ecbarnes116/TAMU_ECEN_403-404_Shared/README.md

# TAMU_ECEN_403-404_Shared
Shared repository for Team 34 - Sandia National Laboratories
