ecbarnes116/TAMU_ECEN_403-404_Shared/403Reports_Presentations/ECEN_403_PHEEDAQ_Final_Update_Presentation.pdf

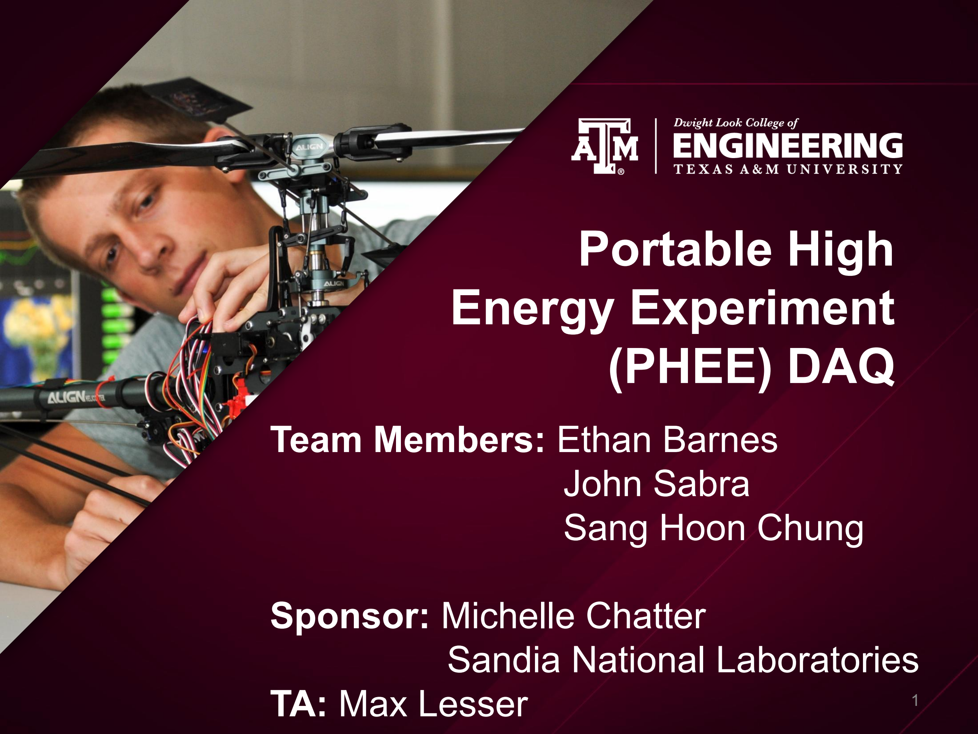
[picture p9: page 1]

# Portable High Energy Experiment (PHEE) DAQ

## Team Members: Ethan Barnes John Sabra Sang Hoon Chung

## Sponsor: Michelle Chatter Sandia National Laboratories

TA: Max Lesser | 1

# Executive Summary

## Problem statement:

- The United States military possesses about 5500 nuclear weapons in its stockpile

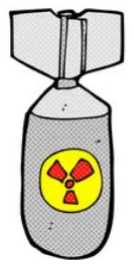
[picture p10: figure]

- The security of these weapons and equipment is paramount when they are transported for storage and testing
- Sandia is interested in detecting explosive-type events in sensitive areas
– Exact application for DAQ system may not be disclosed

## The Portable High Energy DAQ System will:

- Protect government equipment by detecting and identifying explosives within a 100 ft range
– Utilizes microphone, accelerometer, and pressure sensor to classify if an explosive event occurred
- Write output to removable storage device – User will be able to refer to past outputs

# System Overview

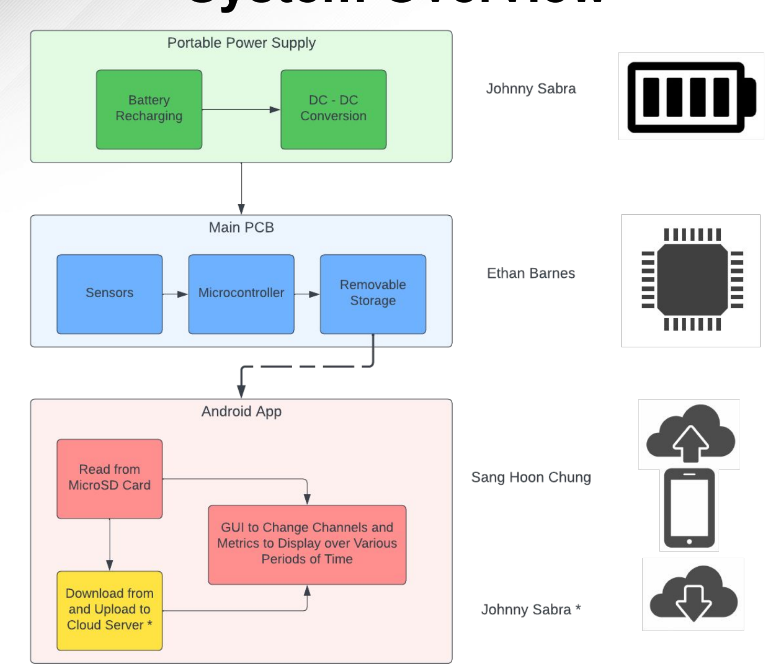
[picture p11: figure]

# Execution and Validation

| March 20th | March 27th | April 3rd | April 10 | April 17
Power Supply | 3 V output from DC/DC Buck | | Buck Converter steps down 5 V | | 5 V output from Power | Power Path IC can take DC input via Micro-USB | Complete PCB
| and get signal to noise ratio | | Detection bit set when certain threshold is | | Write data to SD card in specified | Functioning prototype using dev | PCB design interfaces MCU with sensors and
Android Application | Develop GUI for users to interact | | Read data from SD card and compute | Set up the cloud server account and | Connect from the cloud | Upload and download the data to and from cloud

Converter
input

Path IC

charging

design

Microcontroller Sample at 2 kHz

above 40 dB
passed

format
board
SD card port

with app
metrics on data

file directory

server to app

server

Currently: Outlined needs for each system

# Power Supply Subsystem

Accomplishments since the last presentation

Ongoing progress/problems and plans until the next presentation
- Completed battery charger design
- Adjusted battery charger design for 3-cell battery
- Completed PCB Design
- Began validation circuit for battery charger
- Incorrect breakout adapter footprint for battery charger IC
- Complete battery charger validation
- Measure a voltage output between 4.5 and 5.5V from the battery charger
- Measure the battery charging at a 1C rate

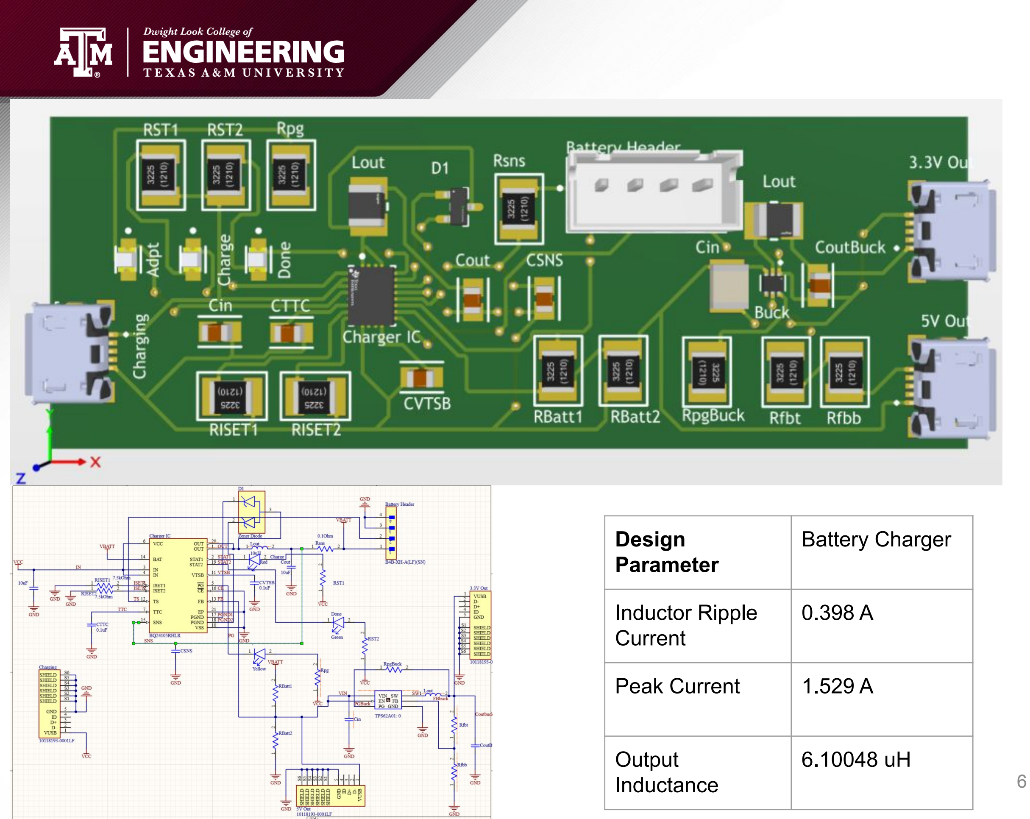
[picture p12: page 6]

Design Parameter | Battery Charger
Inductor Ripple Current | 0.398 A
Peak Current | 1.529 A
| | 6.10048 uH

Output
Inductance

# Microcontroller Subsystem

Accomplishments since the last presentation

Ongoing progress/problems and plans until the next presentation
- Able to read data from all 5 channels of ADC at 100 kHz
- Using SDIO 1-bit to write to SD card
- Detection bit set when specified threshold is passed
- Read data from signal
conditioner
- Replace batteries and mount BNC connectors for sensors
- Need to begin PCB design
- Will begin this week (maybe with help from Johnny)
- Date/time information for each sample
- Using RTC, but can’t currently get time in microseconds
- Writing to SD card is too slow
- SDIO 4-bit write not working currently, reached out for help and could not fix, could be issue with jumper wires

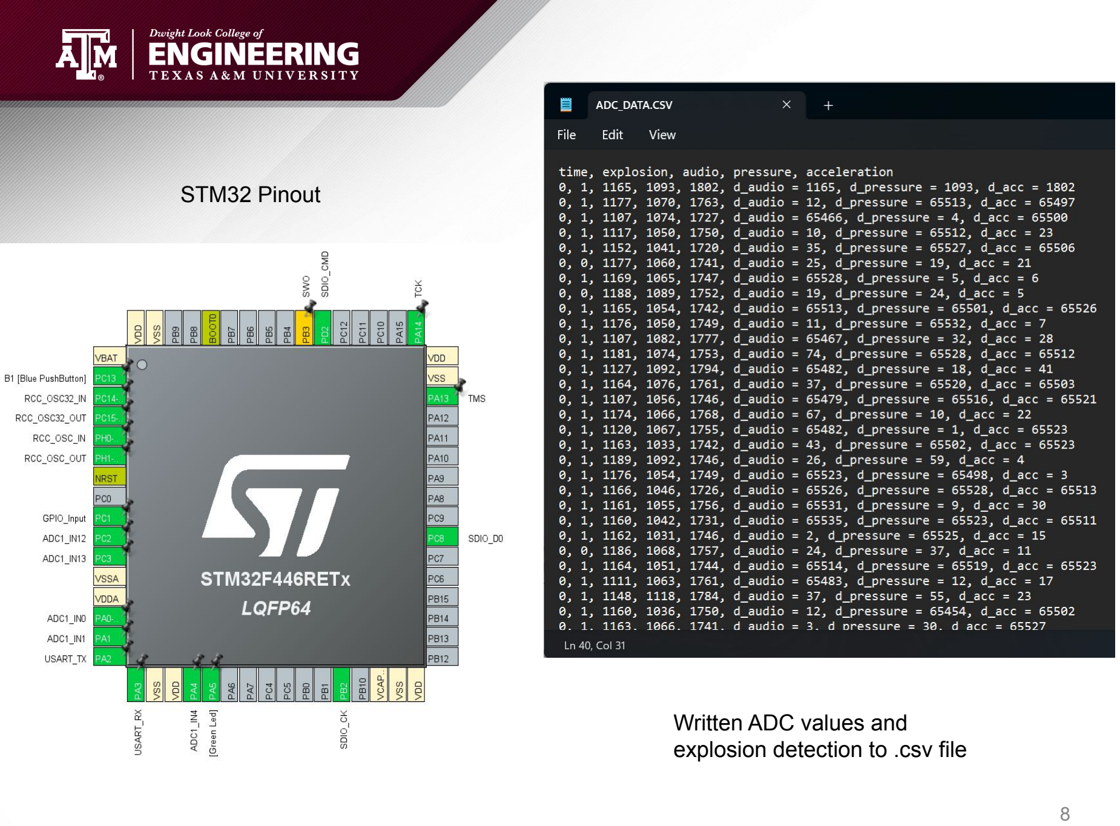
[picture p13: page 8]

Written ADC values and
explosion detection to .csv file

STM32 Pinout

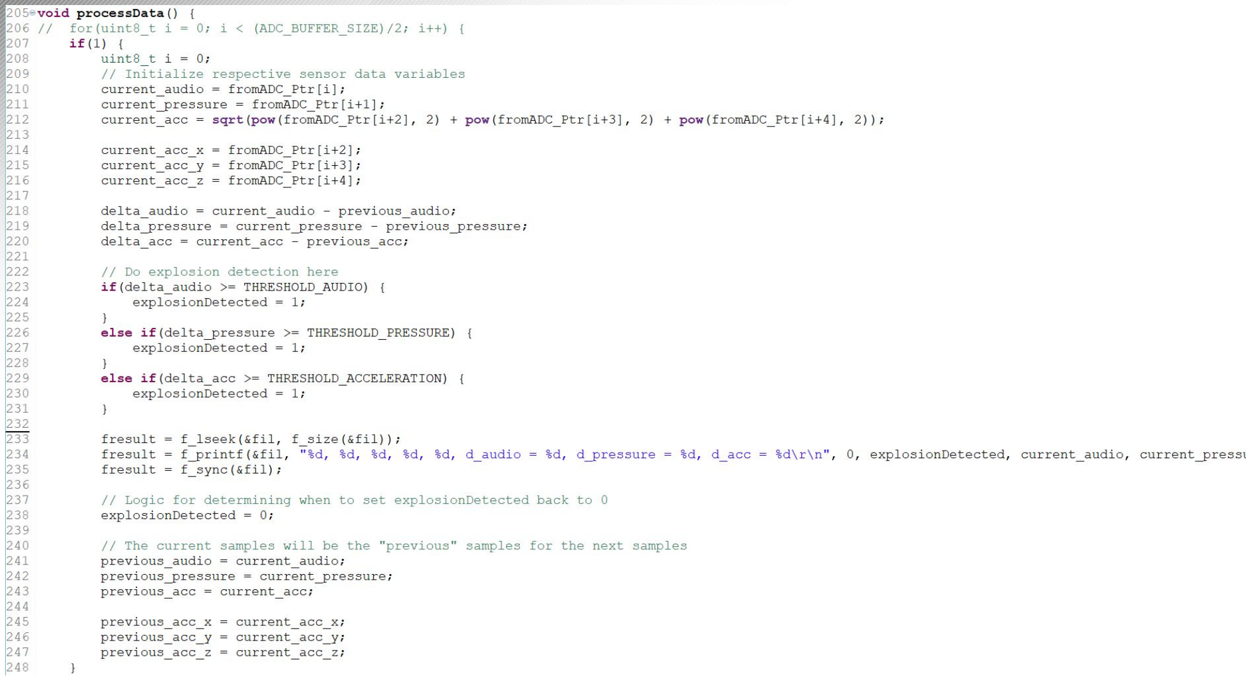
[picture p14: figure]

Main function to process data from ADC and save to SD card - needs improvement

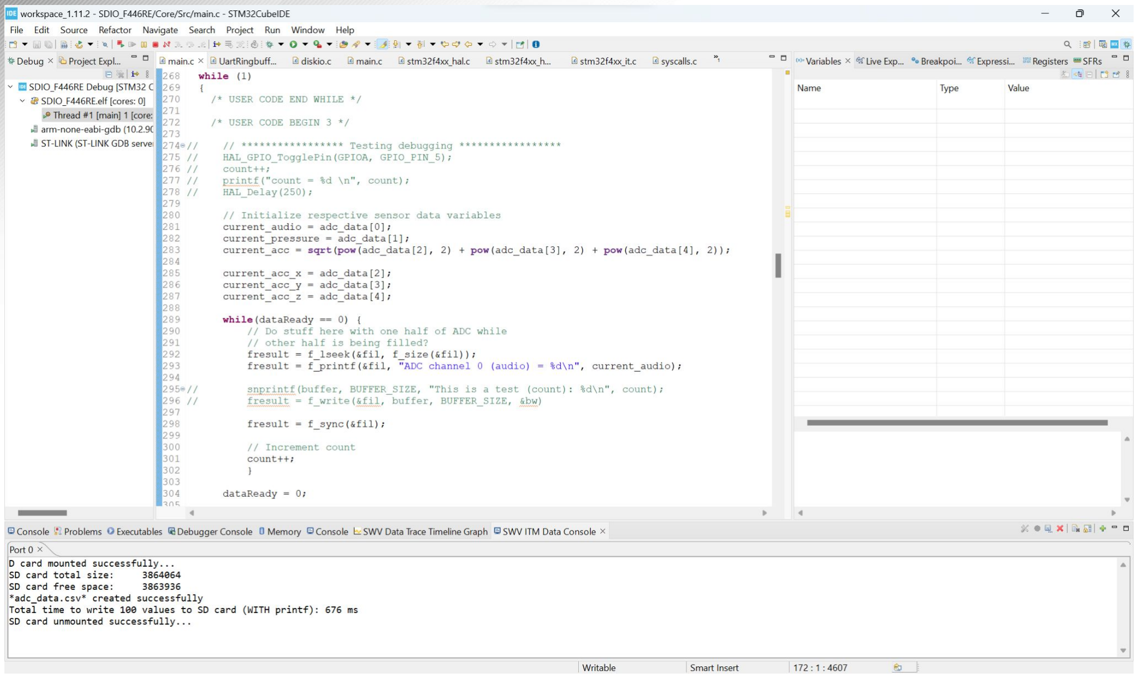
[picture p15: figure]

Debug print to console to verify that the SD card was mounted, the file was created and written to, and the SD card was unmounted

Shows how long it took to write n values to SD card (currently too slow)

# Android Application Subsystem

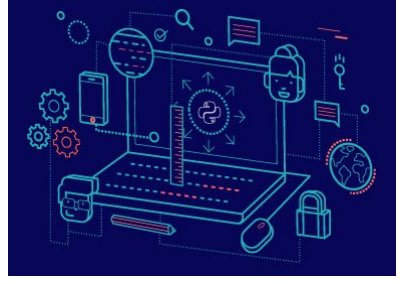
[picture p16: figure]

## •GUI should select different channels to display a small sample of the data (summary of data collected such as max, min, avg data points, Max FFT, and presence of the explosion)

## •View signal data from either cloud server or microSD

card and save the file to Cloud Storage.

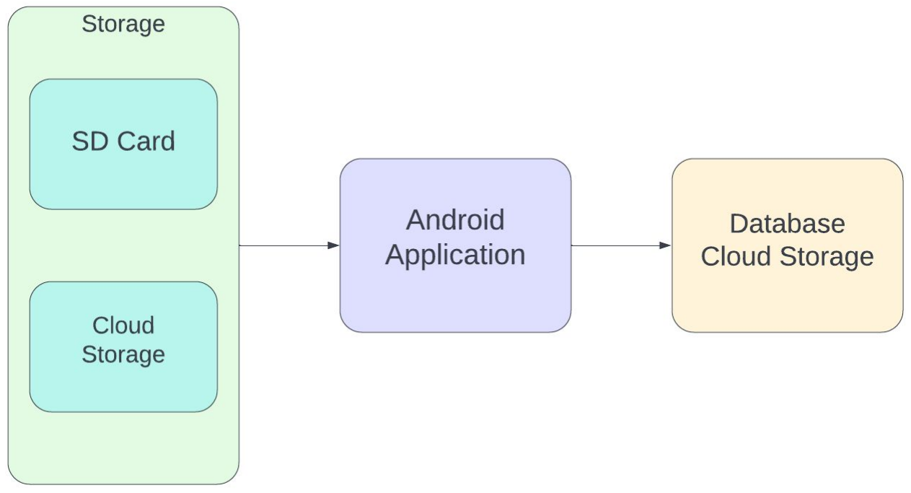
[picture p17: figure]
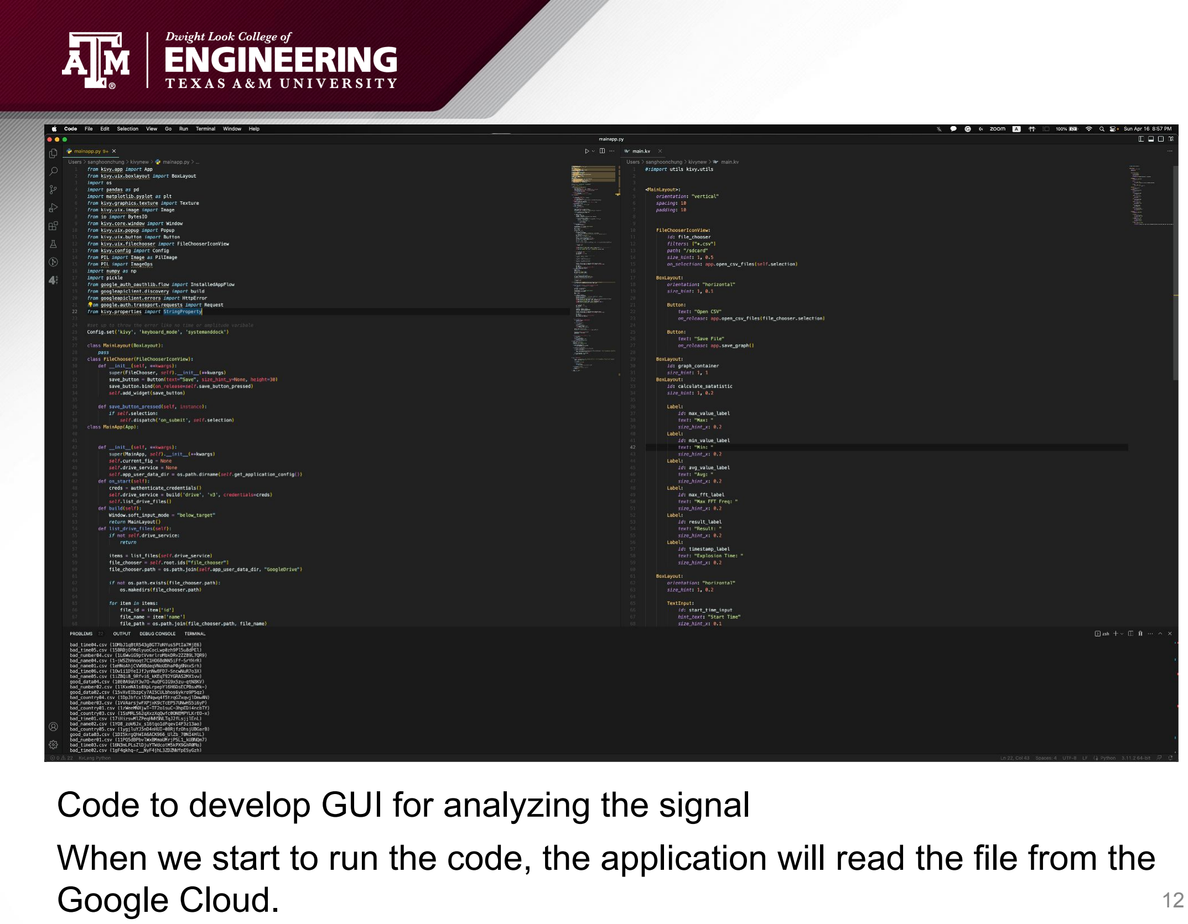
[picture p18: page 12]

Code to develop GUI for analyzing the signal
When we start to run the code, the application will read the file from the
Google Cloud. | 12

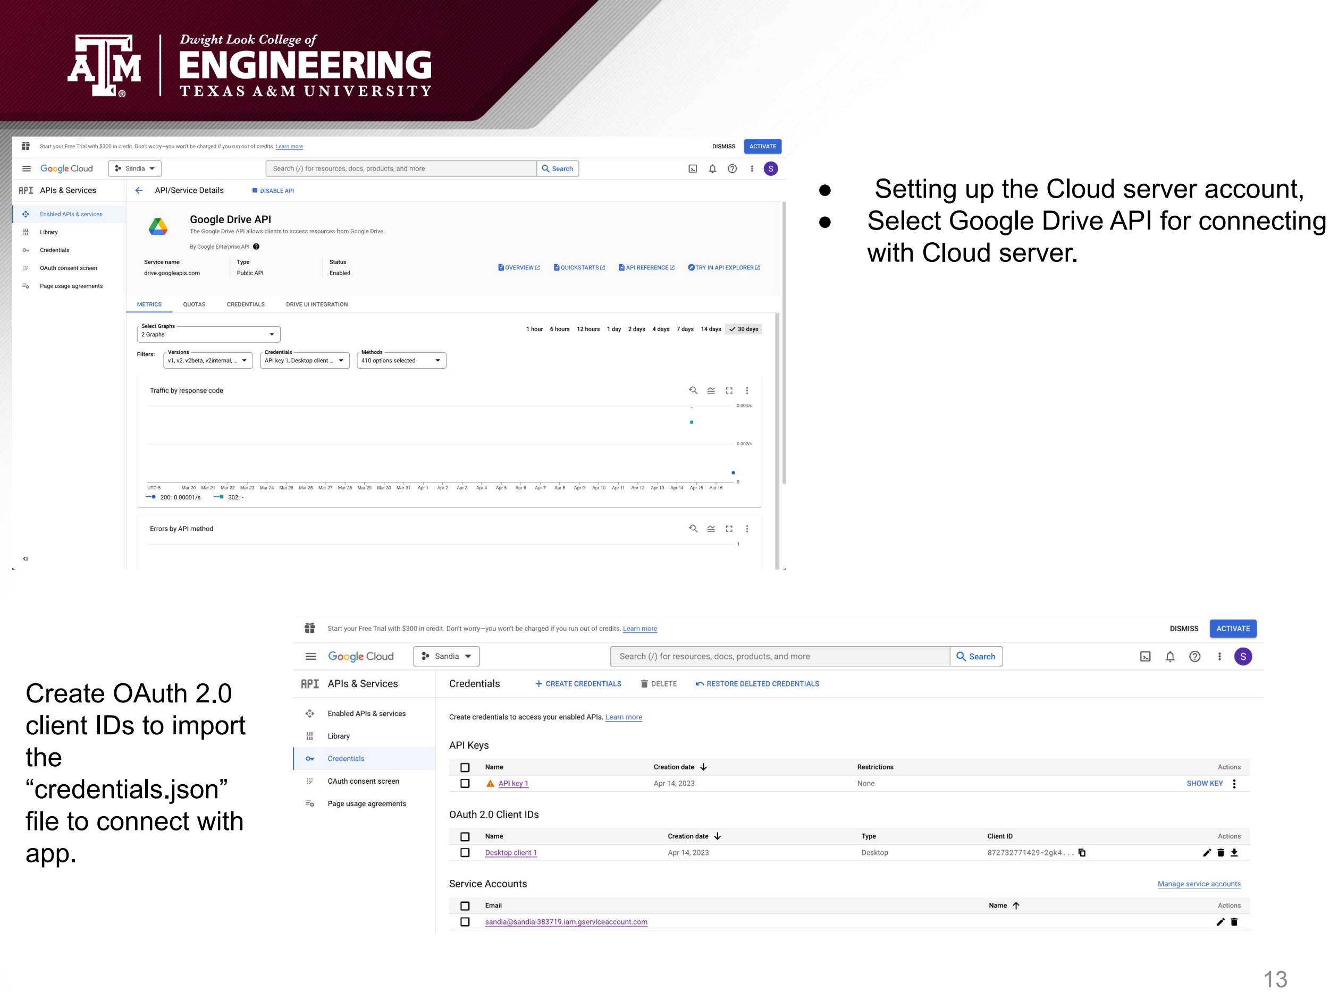
[picture p19: page 13]

- Setting up the Cloud server account,
- Select Google Drive API for connecting with Cloud server.

Create OAuth 2.0
client IDs to import
the
“credentials.json”
file to connect with
app.

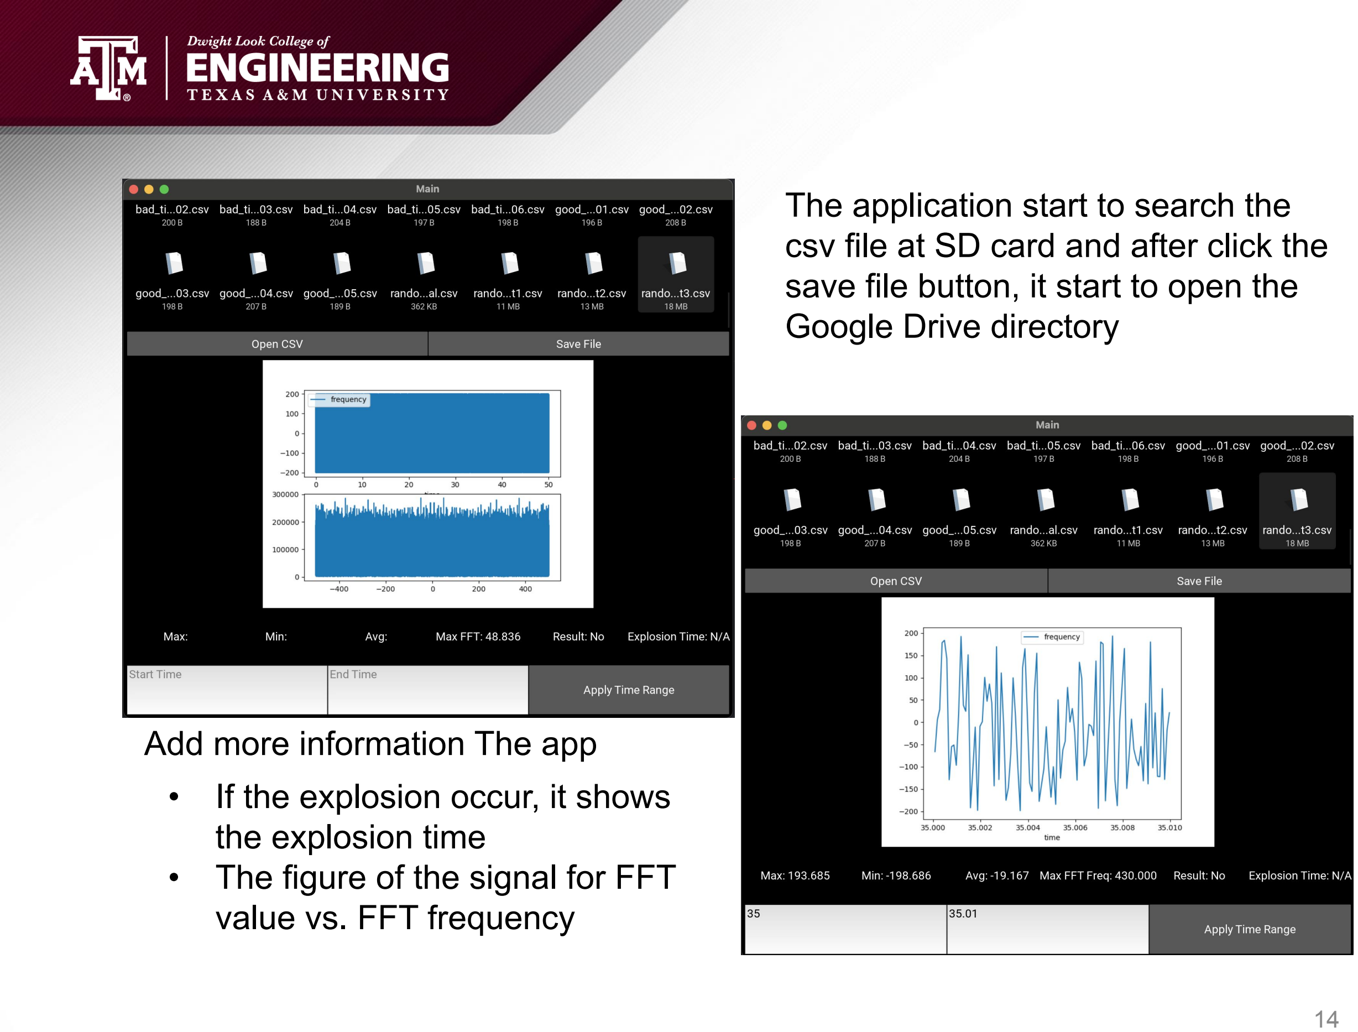
[picture p20: page 14]

Add more information The app
- If the explosion occur, it shows the explosion time
- The figure of the signal for FFT value vs. FFT frequency

The application start to search the csv file at SD card and after click the save file button, it start to open the Google Drive directory

# Goals for future - Power Supply Subsystem

403 Goals | 404 Goals
- Validate battery charger circuit ● Obtain voltage ripple and inductor current ripple values for power supply using E-load | ● Interface power supply PCB with MCU PCB ● Test power supply PCB ● Validate PCB to meet voltage and current ripple requirements

# Goals for future - Microcontroller Subsystem

403 Goals | 404 Goals
- Complete PCB design ● Interface signal conditioner with MCU ● Increase SD card write speed | ● Improve PCB design to include user interaction to turn on board, reset board, and remove SD card card safely ● Interface with power supply subsystem

# Goals for future - Android Application Subsystem

403 Goals | 404 Goals
- Deploy the app to computer and smartphone ● Read more than one signal ● Debugging for malfunctioning. ● Upload the signal from SD card to Cloud storage | ● Validate and test communication between subsystems ● Keep debugging for the application
