ecbarnes116/TAMU_ECEN_403-404_Shared/403Reports_Presentations/ECEN_403_PHEEDAQ_Status_Update_Presentation-2.pdf

# Portable High Energy Experiment (PHEE) DAQ

## Team Members: Ethan Barnes John Sabra Sang Hoon Chung

## Sponsor: Michelle Chatter Sandia National Laboratories

TA: Max Lesser | 1

# System Overview


# Execution and Validation

| March 20th | March 27th | April 3rd | April 10 | April 17
Power Supply | 3 V output from DC/DC Buck | | Buck Converter steps down the Power Path IC’s | 5 V output from Power | | Power Path IC can take DC input via USB | Battery charges at 1C
| 100 kHz and get signal to noise ratio above 40 | Detection algorithm is (Unverifiable) | | Write data to SD card in specified | Functioning prototype using dev | PCB design interfaces MCU with sensors and
Android Application | Develop GUI for users to interact | | Read data from SD card and compute | Set up the cloud server account and | Connect from the cloud | | Upload and download the data to and from cloud

Converter
output

Path IC

charging

rate

Microcontroller Sample at 2 kHz

dB

90% accurate*
format
board
SD card port

with app
metrics on data

file directory

server to app

server

Currently: Outlined needs for each system

Power Supply Subsystem | John Sabra

Accomplishments since the last
presentation

Ongoing progress/problems and plans until the next presentation
- Completed buck converter design and simulation
- Completed buck converter validation circuit
- Began PCB design for buck converter and battery charger
- Completed external part
footprints for both battery charger and buck converter
- Began battery charger design
- Completing Battery charger Design
- Measure a voltage output between 4.5 and 5.5V from the battery charger
- Complete PCB footprint
- Adjusting battery charger design for 3-cell battery

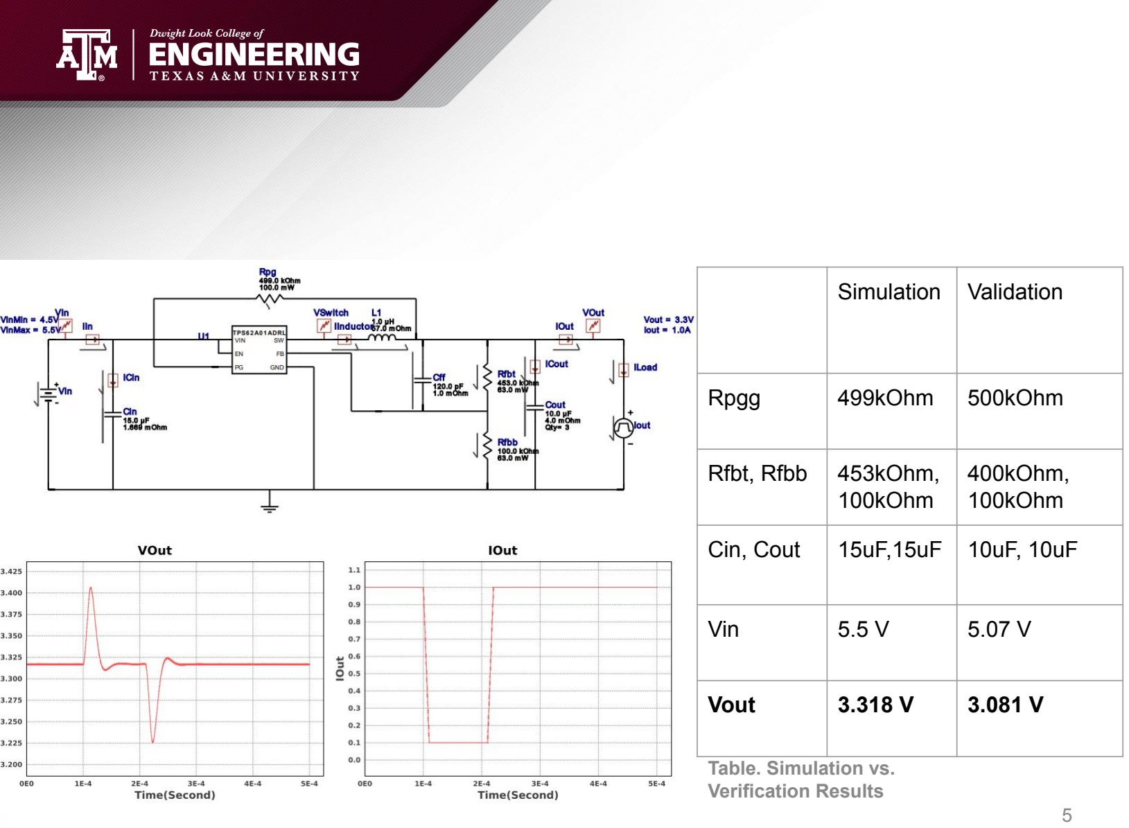
[picture p21: page 5]

| Simulation | Validation
Rpgg | 499kOhm | 500kOhm
Rfbt, Rfbb | 453kOhm, 100kOhm | 400kOhm, 100kOhm
Cin, Cout | 15uF,15uF | 10uF, 10uF
Vin | 5.5 V | 5.07 V
Vout | 3.318 V | 3.081 V

Table. Simulation vs.
Verification Results

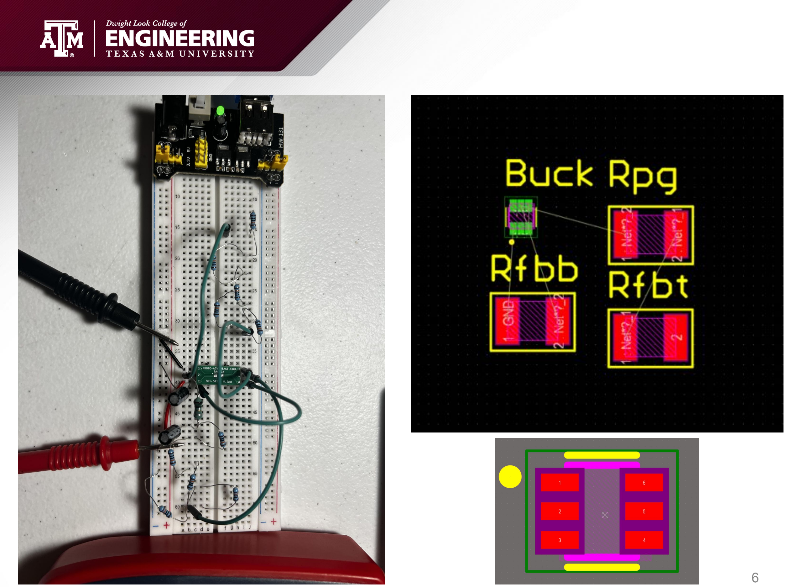
[picture p22: page 6]

Microcontroller Subsystem | Ethan Barnes

Accomplishments since the last
presentation

Ongoing progress/problems and plans until the next presentation
- Able to read data from all 5 channels of ADC at 100 kHz
- Code implemented to mount SD card every time the program is run and save test files
- Can’t output through serial monitor for debugging
- Need to interface SD card reader with MCU to confirm code works
- Still don’t have signal
conditioner from Sandia to power sensors
- Need to begin PCB design

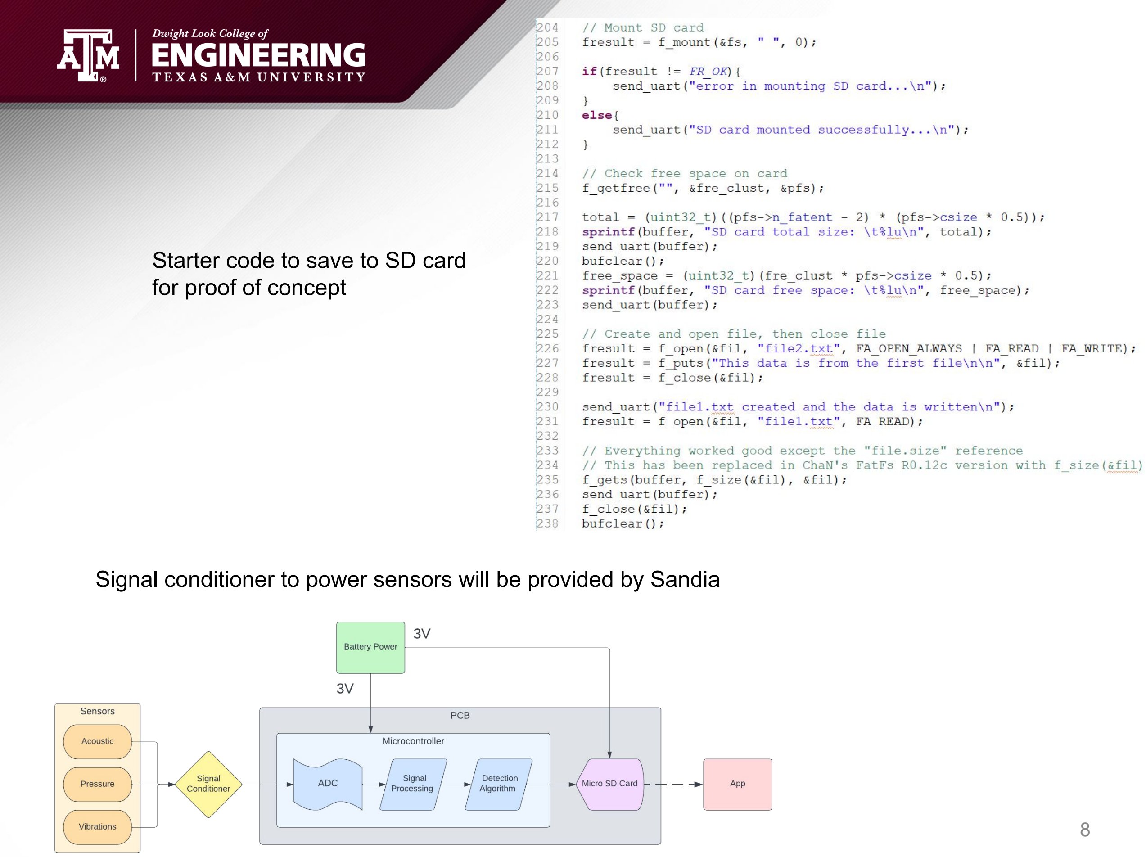
[picture p23: page 8]

Signal conditioner to power sensors will be provided by Sandia

Starter code to save to SD card for proof of concept

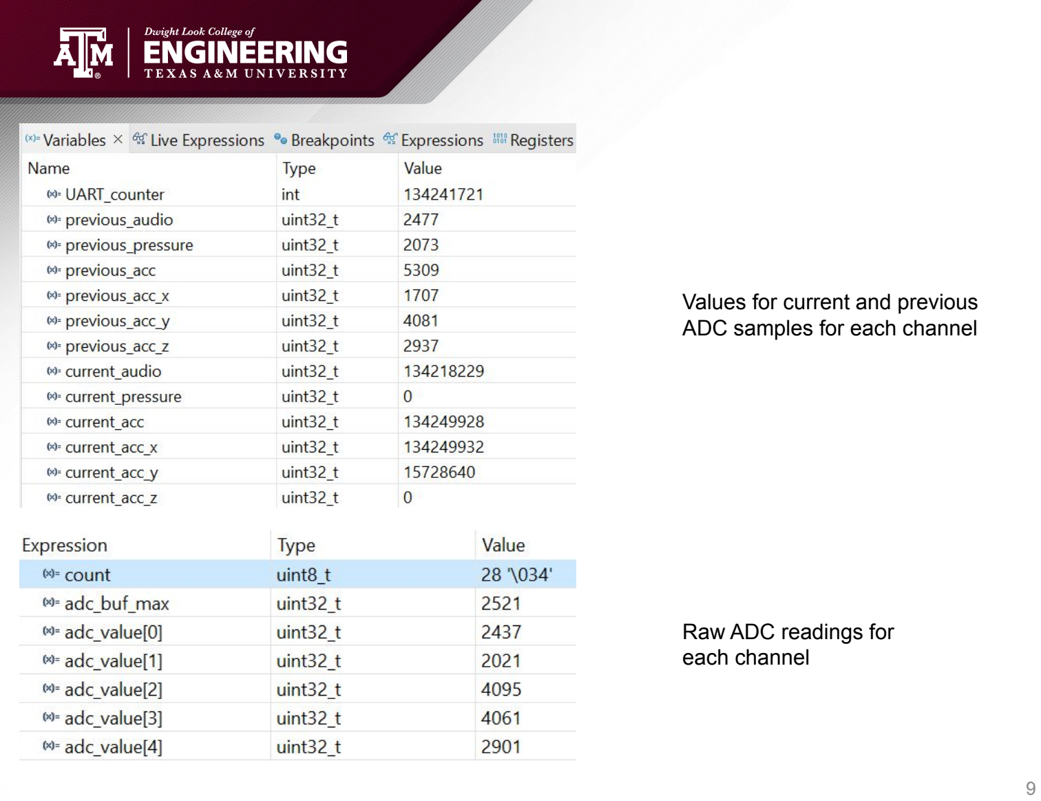
[picture p24: page 9]

Values for current and previous ADC samples for each channel

Raw ADC readings for
each channel

Android Application Subsystem | Sang Hoon Chung

Accomplishments since the last
presentation

Ongoing progress/problems and plans until the next presentation

- Develop GUI for users to interact with app using KIVY Framework
- Read data from SD card and compute metrics on data (Max, Min, Avg, FFT, and presence or absence of explosion)
- Upload and download the data
- Deploy the app to computer and smartphone
- Set up the cloud server account and file directory
- Connect from the cloud server to app

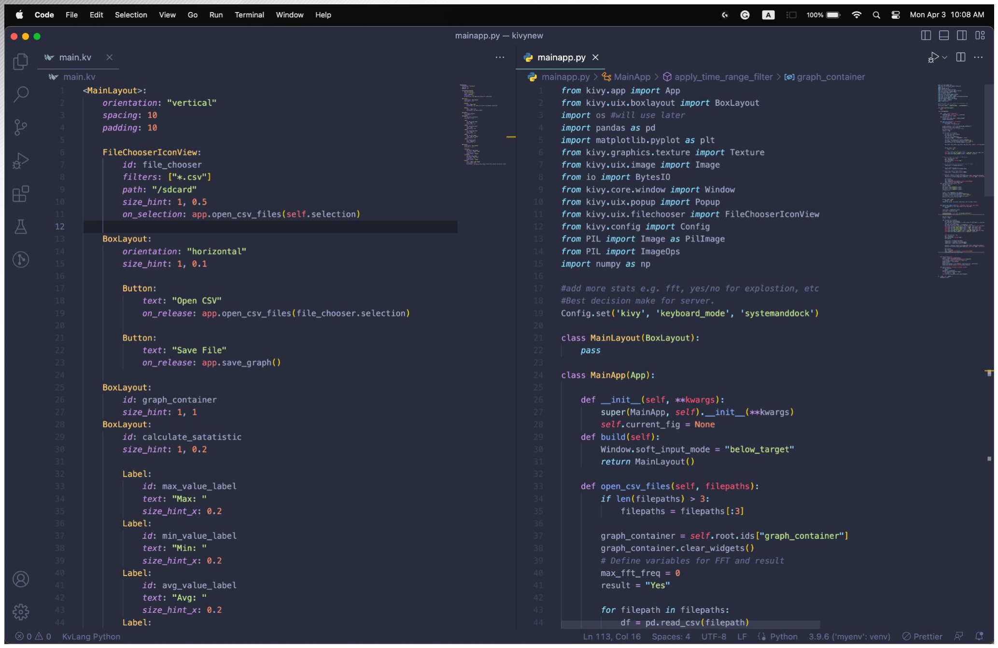
[picture p25: figure]

## Code to develop GUI for analyzing the signal

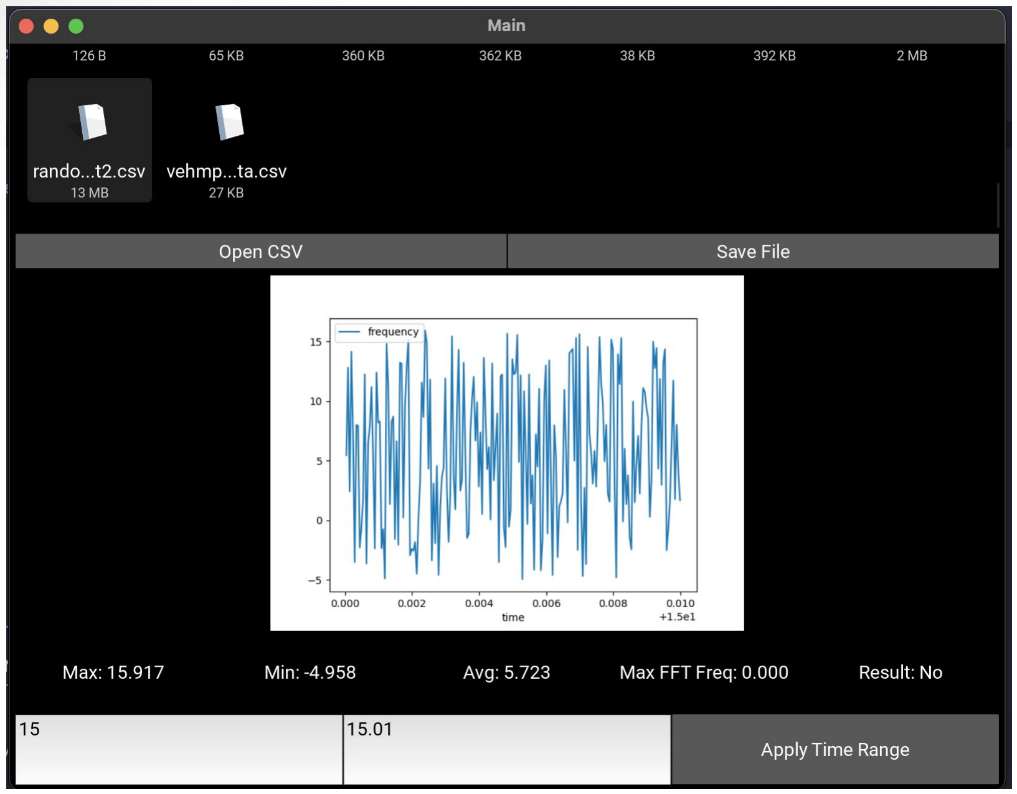
[picture p26: figure]

The app shows: • Open and Save file

button
- The figure of the
signal
- The information value
from the signal
- Time adjustment
button
