ecbarnes116/TAMU_ECEN_403-404_Shared/404 Presentation.pdf

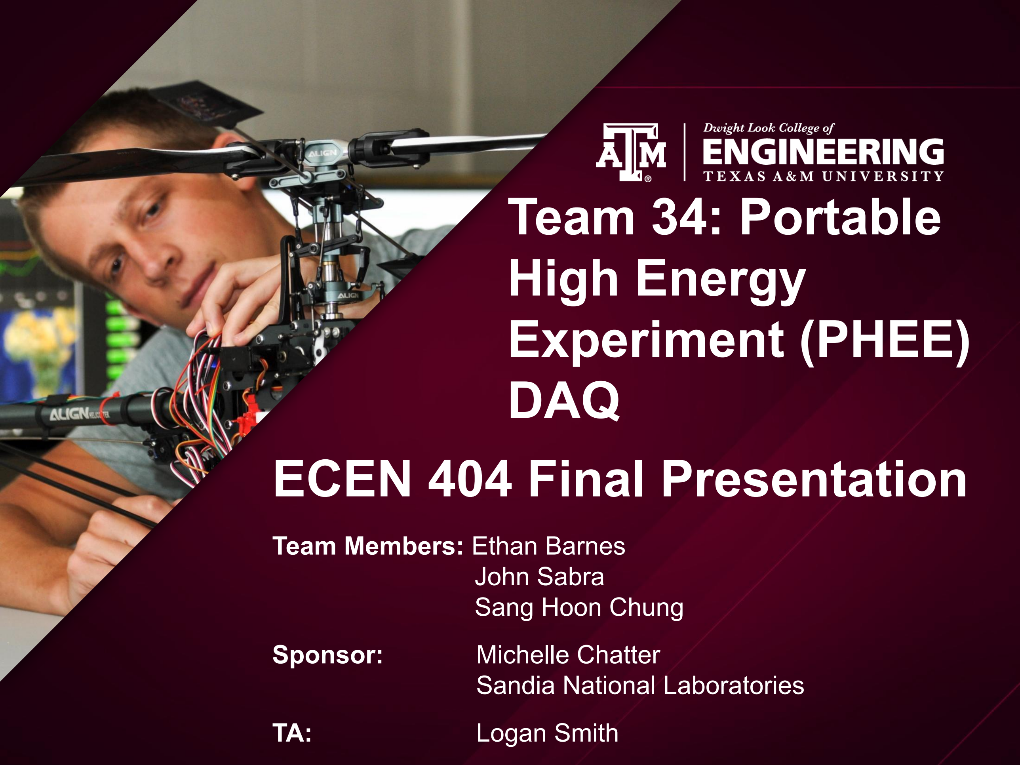
[picture p28: page 1]

# Team 34: Portable High Energy Experiment (PHEE) DAQ

## Team Members: Ethan Barnes John Sabra Sang Hoon Chung

Sponsor: | Michelle Chatter Sandia National Laboratories
TA: | Logan Smith

# ECEN 404 Final Presentation

# Project Summary

# Problem statement:

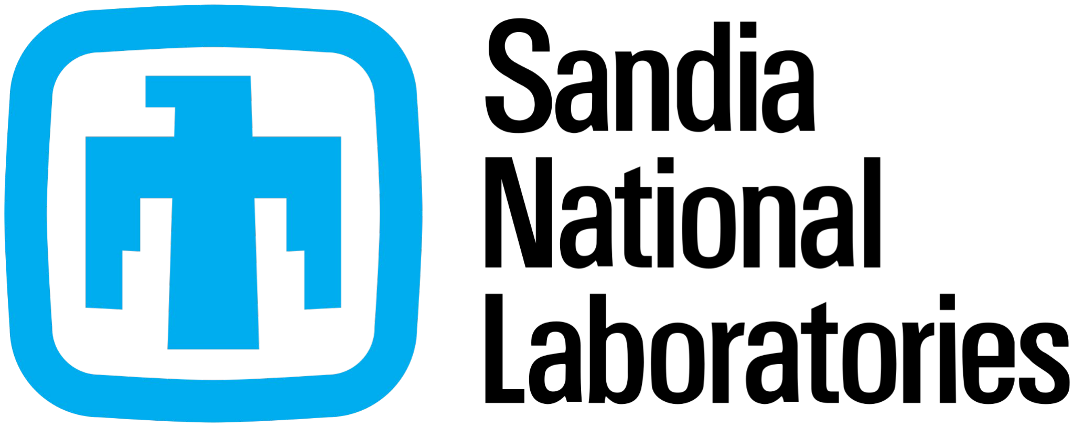
[picture p29: figure]

## - The United States military possesses about 5500 nuclear weapons in its stockpile

## - The security of these weapons and equipment is paramount when they are transported for storage and testing

## - Sandia is interested in detecting explosive-type events in sensitive areas – Exact application for DAQ system may not be disclosed

# The Portable High Energy DAQ System will:

## - Protect government equipment by detecting and identifying explosives within a 100 ft range – Utilizes a pressure sensor to classify if an explosive event occurred - Write output to removable storage device – User will be able to refer to and perform analysis on past data

# Integrated Project Diagram

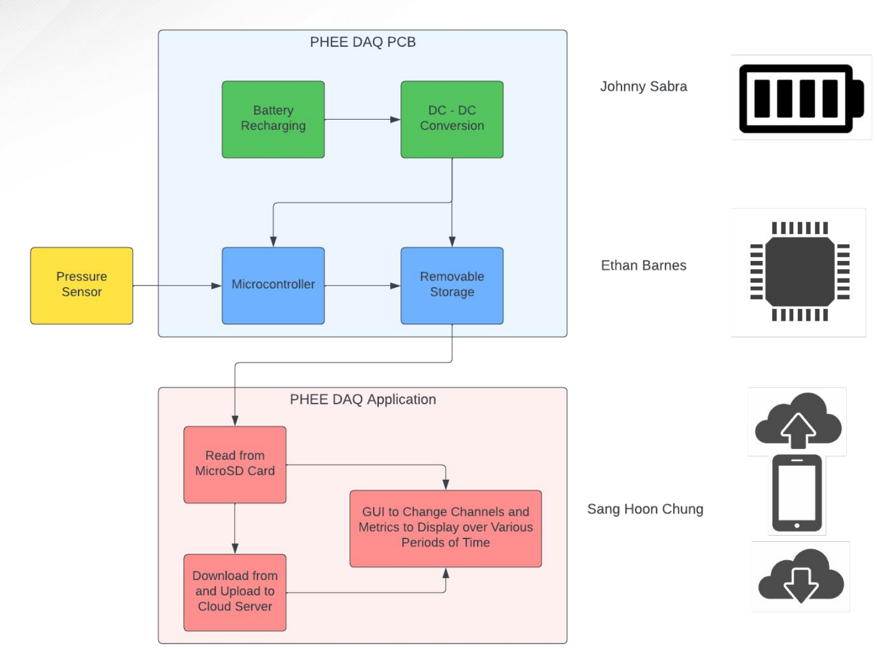
[picture p30: figure]

# Integrated Project Diagram

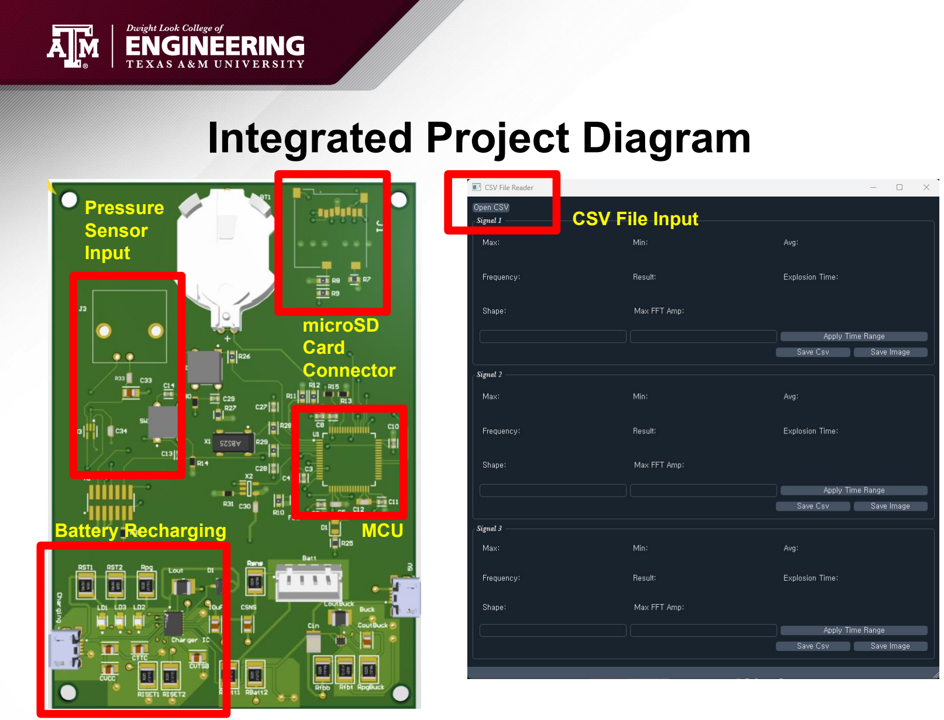
[picture p31: page 4]

Pressure
Sensor
Input

microSD
Card
Connector
Battery Recharging | MCU

CSV File Input

# DC Power Supply

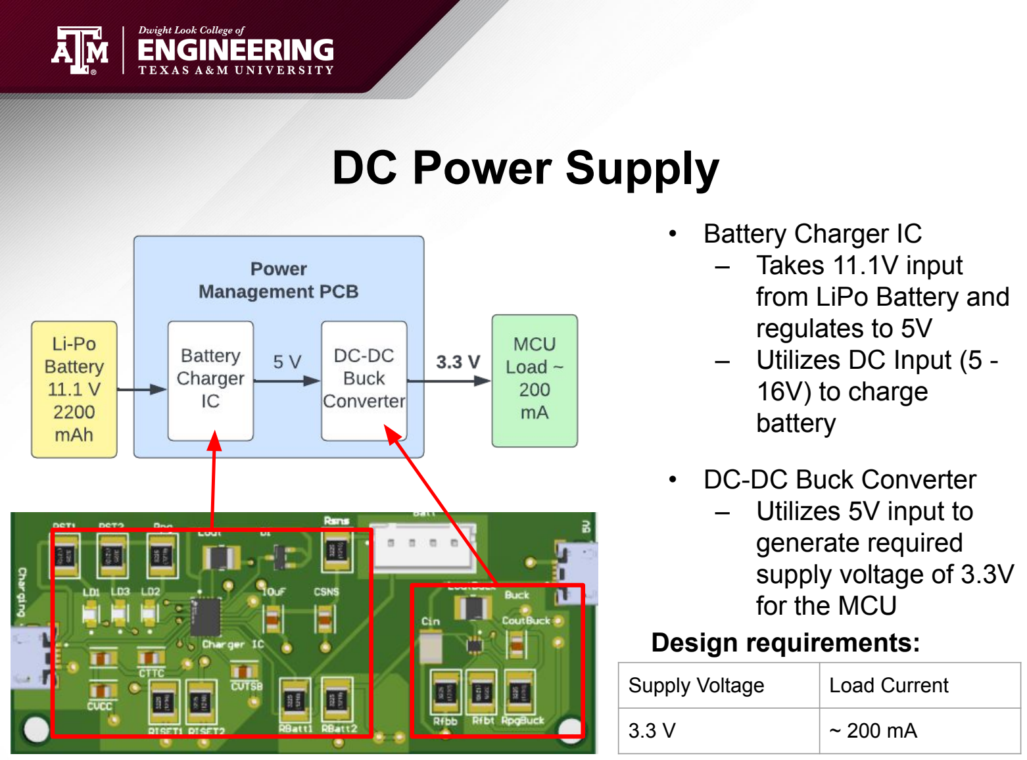
[picture p32: page 5]

## - Battery Charger IC – Takes 11.1V input from LiPo Battery and regulates to 5V – Utilizes DC Input (5 -16V) to charge battery

## - DC-DC Buck Converter – Utilizes 5V input to generate required supply voltage of 3.3V for the MCU Design requirements:

Supply Voltage | Load Current
3.3 V | ~ 200 mA

# Validation

## - DC-DC buck converter output validated at 3.3138 V under normal

load.

## - Challenge: Battery charger output tested at 2.8 V(outside buck converter input range) – solution to switch from 3-cell battery to 1-cell battery pending

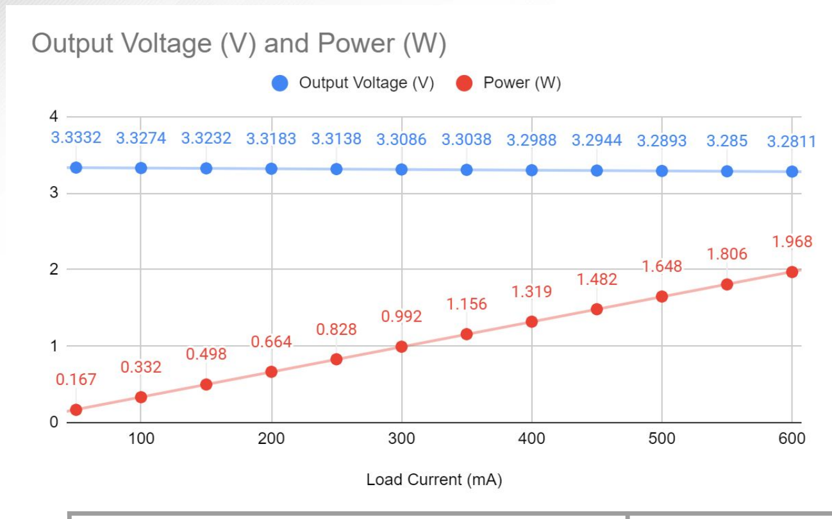
[picture p33: figure]

Average Output Voltage | 3.3064 V
Output Voltage Under Load | 3.3183 V
Average Power | 1.071666667 W

# Microcontroller PCB

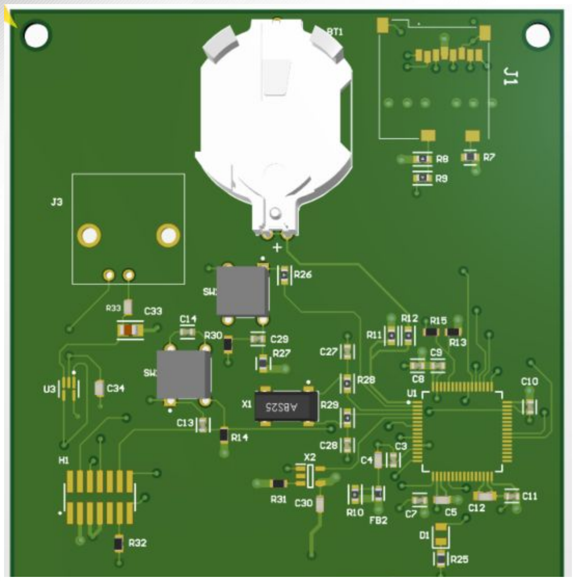
[picture p34: figure]

Device | Measured Voltage | Expected Voltage
Micro USB Output | 5.001 V | 5 V
LDO Regulator Output | 3.318 V | 3.3 V
MCU VDD Input | 3.3179 V | 3.3 V
microSD I/O Input | 3.3027 V | 3.3 V
- PCB is powered with 5V USB output from laptop or 5V output from Power Supply Subsystem
- MCU reads data from pressure sensor

# Microcontroller PCB

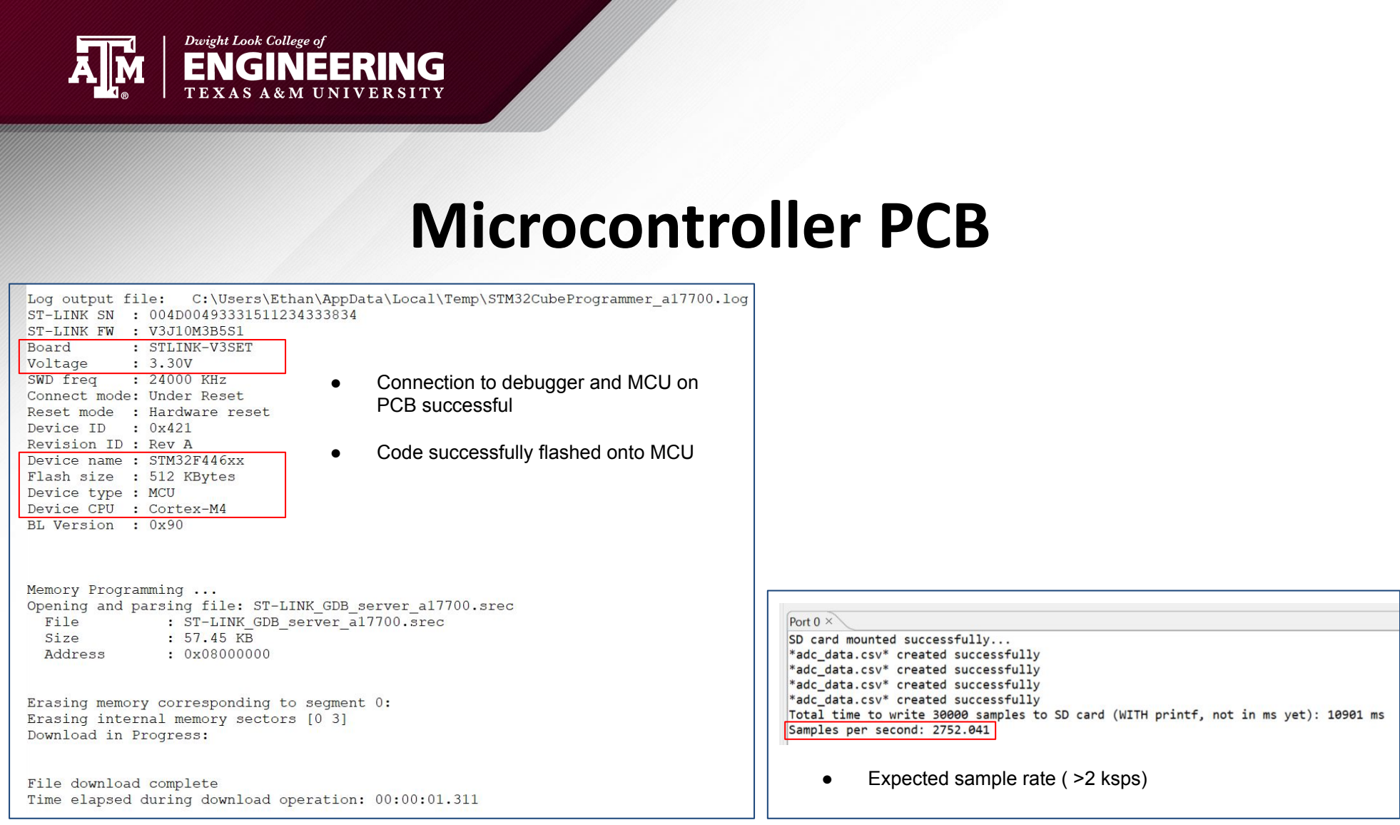
[picture p35: page 8]

- Connection to debugger and MCU on PCB successful
- Code successfully flashed onto MCU
- Expected sample rate ( >2 ksps)

# Application

## Challenge 1: Develop a GUI to configure DAQ settings and output “quick looks” of data

## Challenge 2: Accessing and managing signal data from various

sources.


# Application

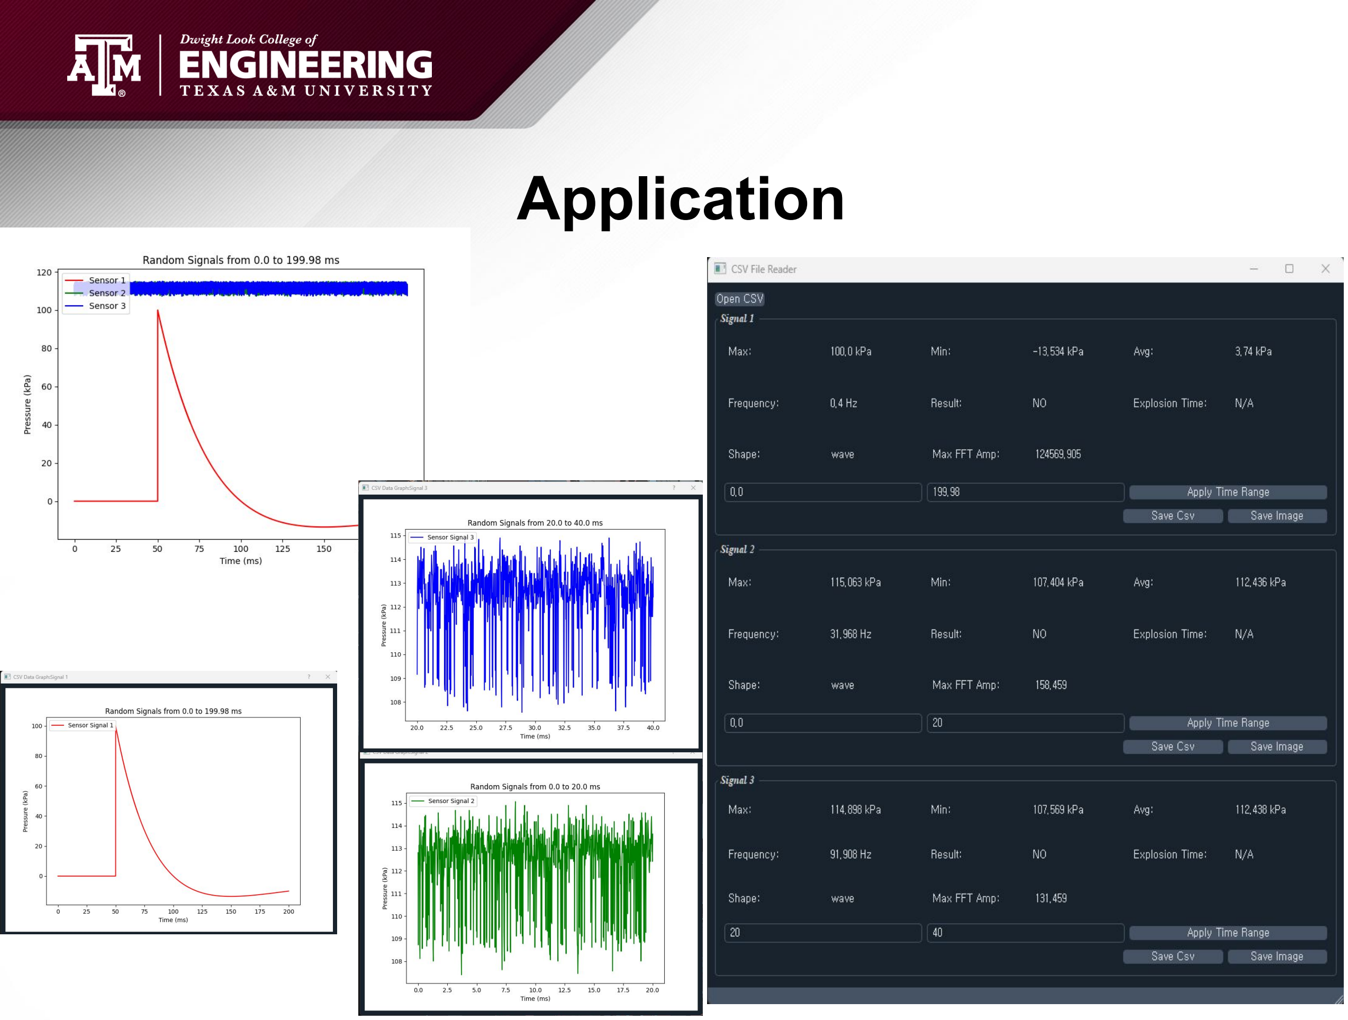
[picture p36: page 10]

# Application

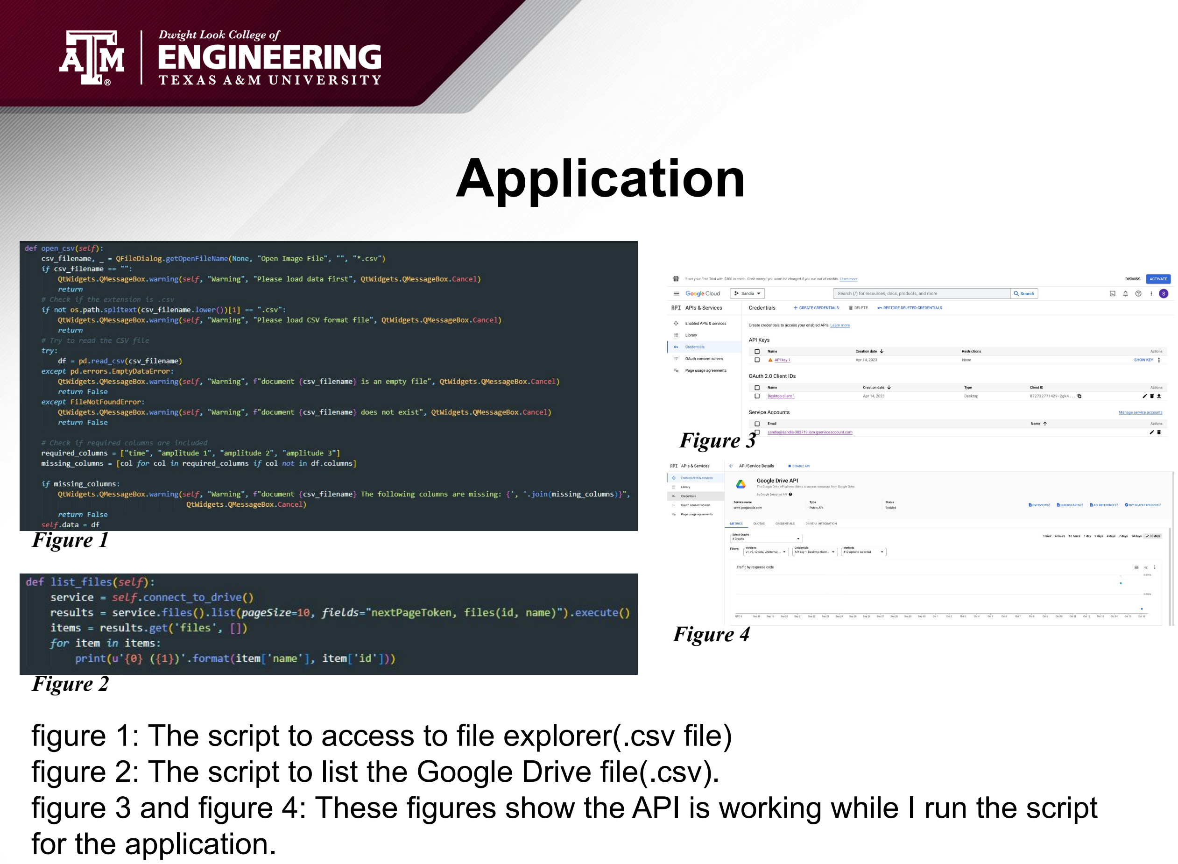
[picture p37: page 11]

Figure 1

Figure 2

Figure 3

Figure 4

## figure 1: The script to access to file explorer(.csv file)

figure 2: The script to list the Google Drive file(.csv).

## figure 3 and figure 4: These figures show the API is working while I run the script

for the application.

# Integrated System Results

Metric | Actual Results | Expected Results
Sampling Rate | ~2752 sps | > 2000 sps
MCU Supply Voltage | 3.3179 V | 3.3 V
Pressure Sensor Reading | Constant ~1.65 V (Constant 112.8 kPa) | 0 V - 2.193 V (0 kPa - 150 kPa)
Power Supply Voltage | 3.3138 V Output Voltage under load | 3.3 V @ 120 mA

# Integrated System Results

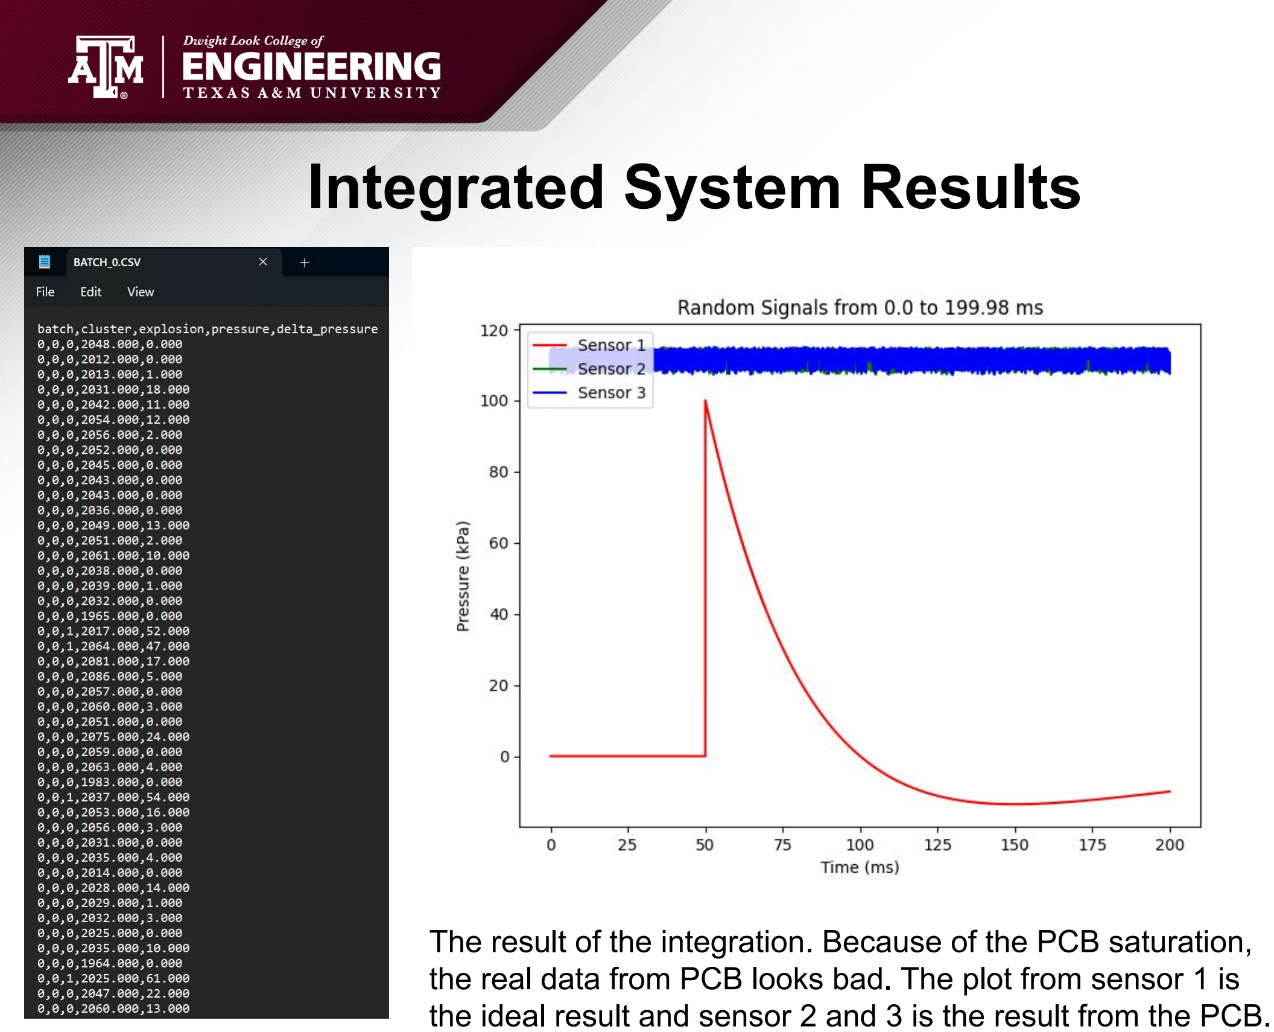
[picture p38: page 13]

The result of the integration. Because of the PCB saturation, the real data from PCB looks bad. The plot from sensor 1 is the ideal result and sensor 2 and 3 is the result from the PCB.

# Conclusions

Issues/Revisions | Status
The 3-cell battery of the power supply is outside the input range of the buck converter. Battery charger is regulating to incorrect voltage. | Power supply was designed to support a 5V DC input via Micro USB to mitigate issues with the battery charger voltage output.
Initially implemented pressure, acceleration, and audio sensors. | Currently only supports pressure sensor input because pressure alone is highly indicative of explosive events.
Op-amp input terminals are swapped. | Input signal needs to enter the positive terminal, but currently enters the negative terminal. Op-amp output (ADC signal input) always saturated because of this. Will order final PCB before 11/8 deadline.
The outputs of the original three sensors are plotted in the GUI. | After we made the decision to only use the pressure sensor, the application doesn't need to plot multiple sensors' data.
