ecbarnes116/TAMU_ECEN_403-404_Shared/ECEN_404_Status_Update_9-11-2023.pdf

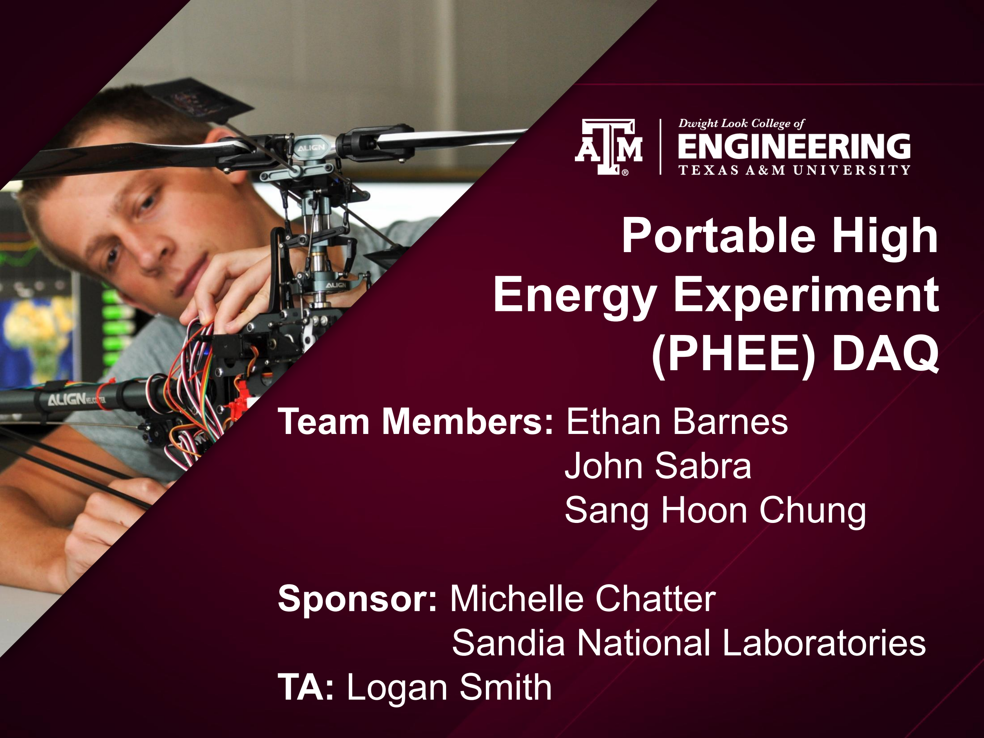
[picture p45: page 1]

# Portable High Energy Experiment (PHEE) DAQ

# Team Members: Ethan Barnes John Sabra Sang Hoon Chung

# Sponsor: Michelle Chatter Sandia National Laboratories TA: Logan Smith


# Project Summary

# Problem statement:

# - The United States military possesses about 5500 nuclear weapons in its stockpile

# - The security of these weapons and equipment is paramount when they are transported for storage and testing

# - Sandia is interested in detecting explosive-type events in sensitive areas – Exact application for DAQ system may not be disclosed

# The Portable High Energy DAQ System will:

# - Protect government equipment by detecting and identifying explosives within a 100 ft range – Utilizes accelerometer and pressure sensor to classify if an explosive event occurred - Write output to removable storage device – User will be able to refer to and perform analysis on past data

# Project/Subsystem Overview


# Team: PHEE DAQ (Sandia)

| 9/10 | 9/24 | 10/8 | 10/22 | 11/5
Johnny | PCB Ordered | Power supply PCB validated | Charging feature validated | Integrated PCB design complete | Integrated PCB is functional
| Zero design violations in Altium | Regulates 3.3 V under 40mA load and 5 V under 120 mA load (estimated load current of MCU) | Can charge a 3-cell lipo battery at 1C rate
Ethan | PCB design complete | MCU runs independently | PCB is functional | Zero design violations in Altium

Can be powered with 3.3V
source and can read from
sensors and write to SD
card at more than 2 kHz

Integrated PCB is
portable with power
supply regulating battery
voltage to 3.3 and 5V
under load
Zero design violations in Altium | Program will start and stop from GPIO outside of debug mode | Powered with 3.3 V source, can write to SD card at ~2 kHz Pressure sensors test pending
Sang Hoon | Change Framework to PyQt and Design multiple signals on GUI | Add more metrics to display for data | Make GUI more user-friendly | Finalizing the program and adopting the software | Validate and test communication between subsystems
| Check the application shows whole sensors data | Add more metrics and check availability of the result Display via the application at next column | Ask opinions to other people about the design of GUI | Check the software works when we download the software itself as .exe file | Application can read data from SD card in desired format (time, explosion, pressure, acceleration)

# Execution

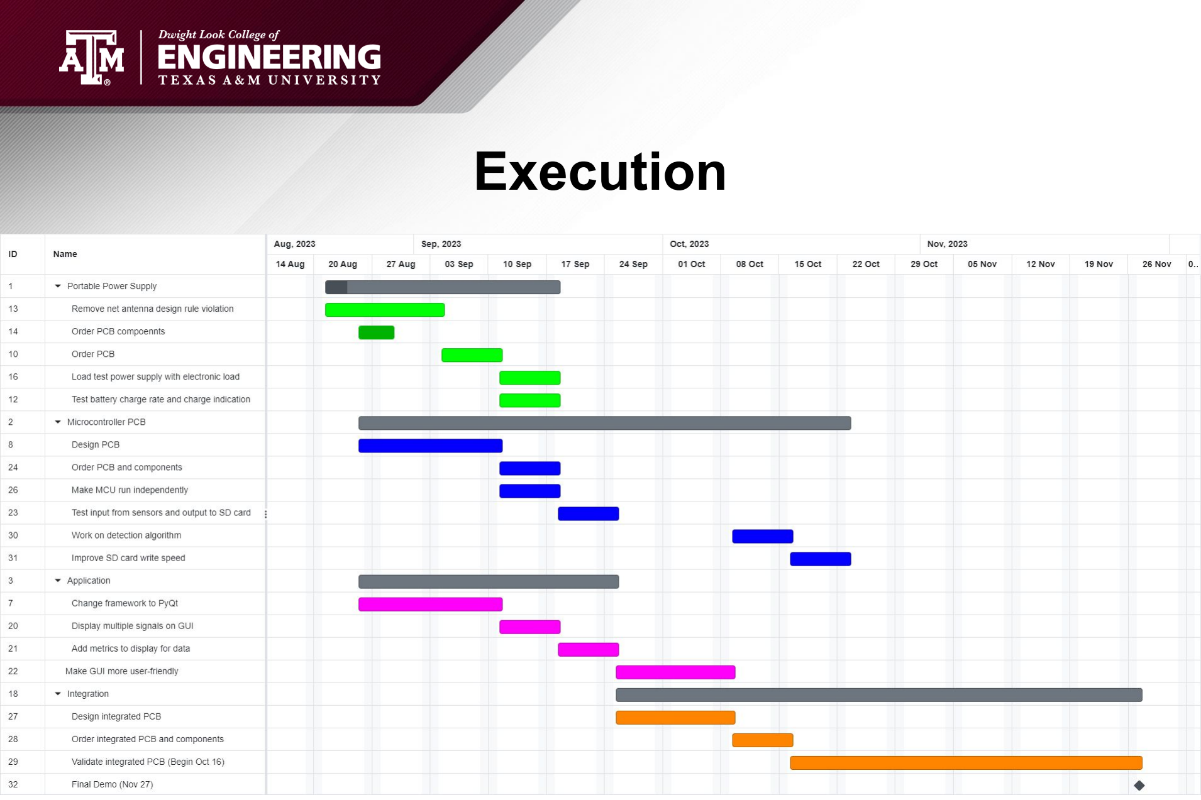
[picture p46: page 5]

Accomplishments since the last presentation <10> hrs | Ongoing progress/problems and plans until the next presentation
- Removed all design violations from PCB designs ● PCB components have arrived and are in hand ● PCB layout ordered with expected arrival this week | ● Solder components onto to PCB ● Begin layout and routing for integrated PCB design between power supply and MCU
Portable Power Supply | Johnny Sabra

# Integrated PCB

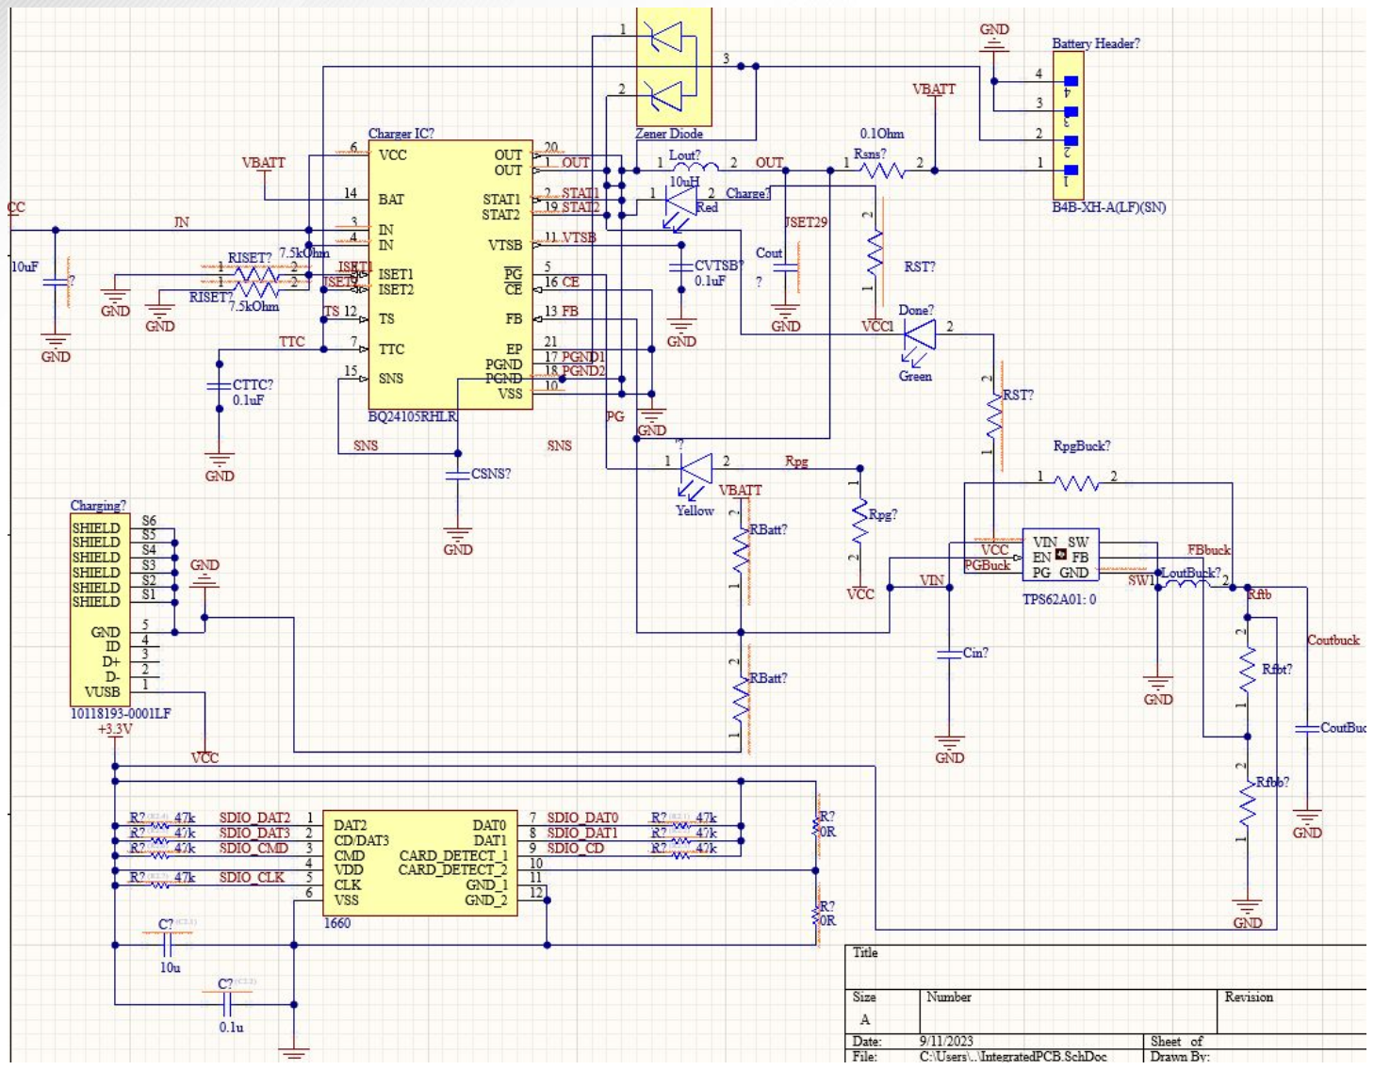
[picture p47: figure]

# - Schematic for power supply and micro SD card reader

# - Schematic symbols include footprints for PCB layout

Accomplishments since the last presentation <20> hrs | Ongoing progress/problems and plans until the next presentation
- microSD reader, power, and sensor input schematics are complete | ● MCU GPIO schematic in progress and then PCB layout will begin
Microcontroller PCB | Ethan Barnes

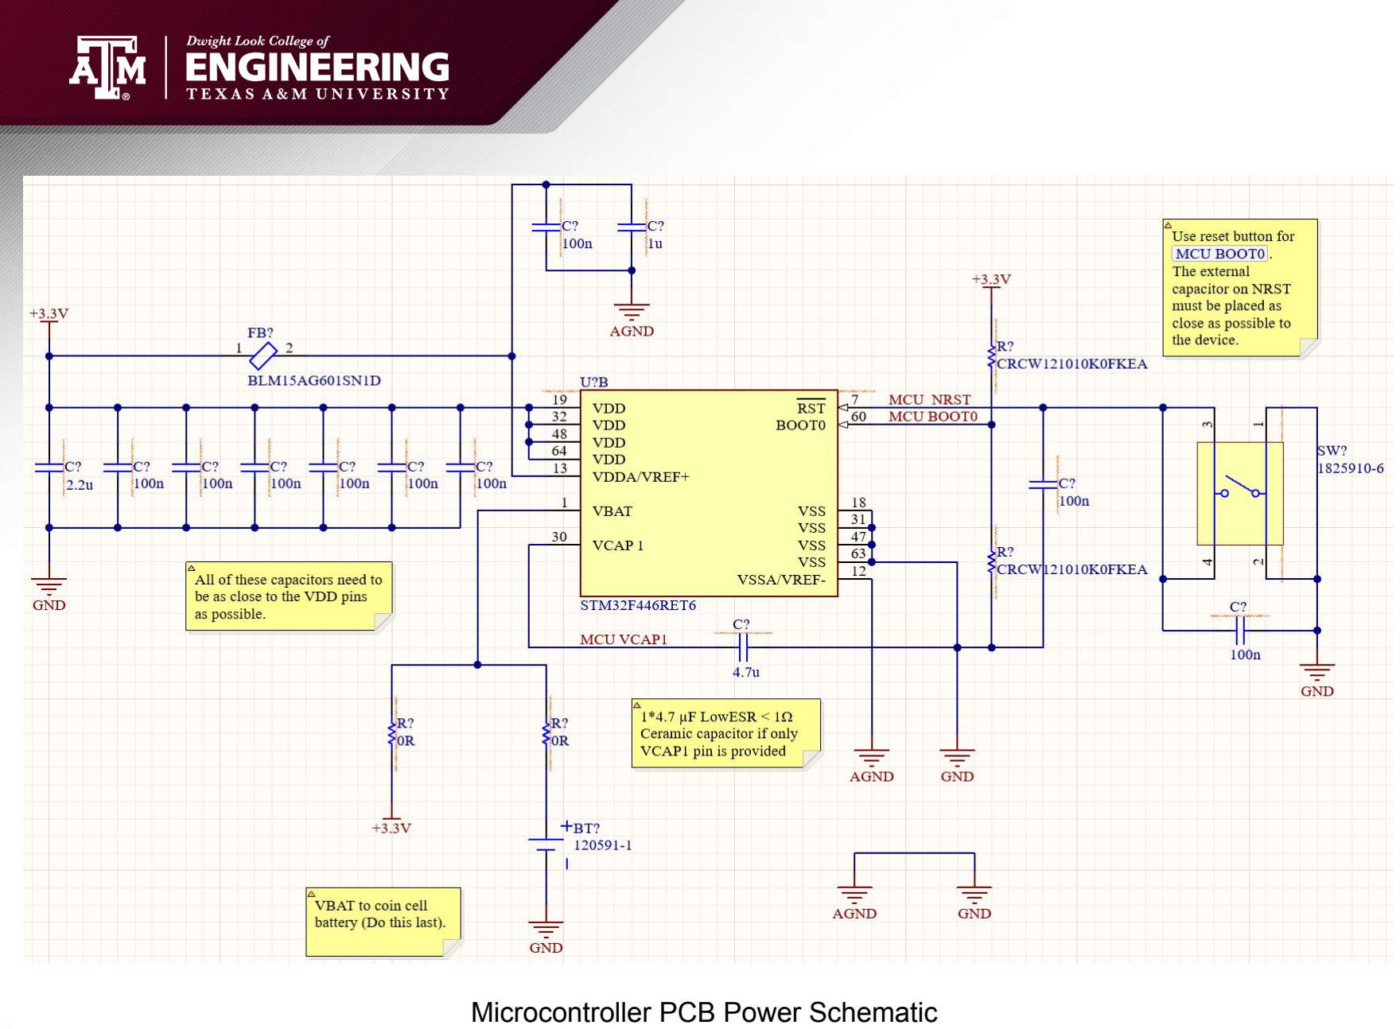
[picture p48: page 9]

## Microcontroller PCB Power Schematic

Application | Sang Hoon Chung
Accomplishments since the last presentation <20> hrs | Ongoing progress/problems and plans until the next presentation
- Change the Framework from Kivy to PyQt which can be used to create desktop applications. | ● Link to Google Drive with using Google API ● Read multiple signals from sensors

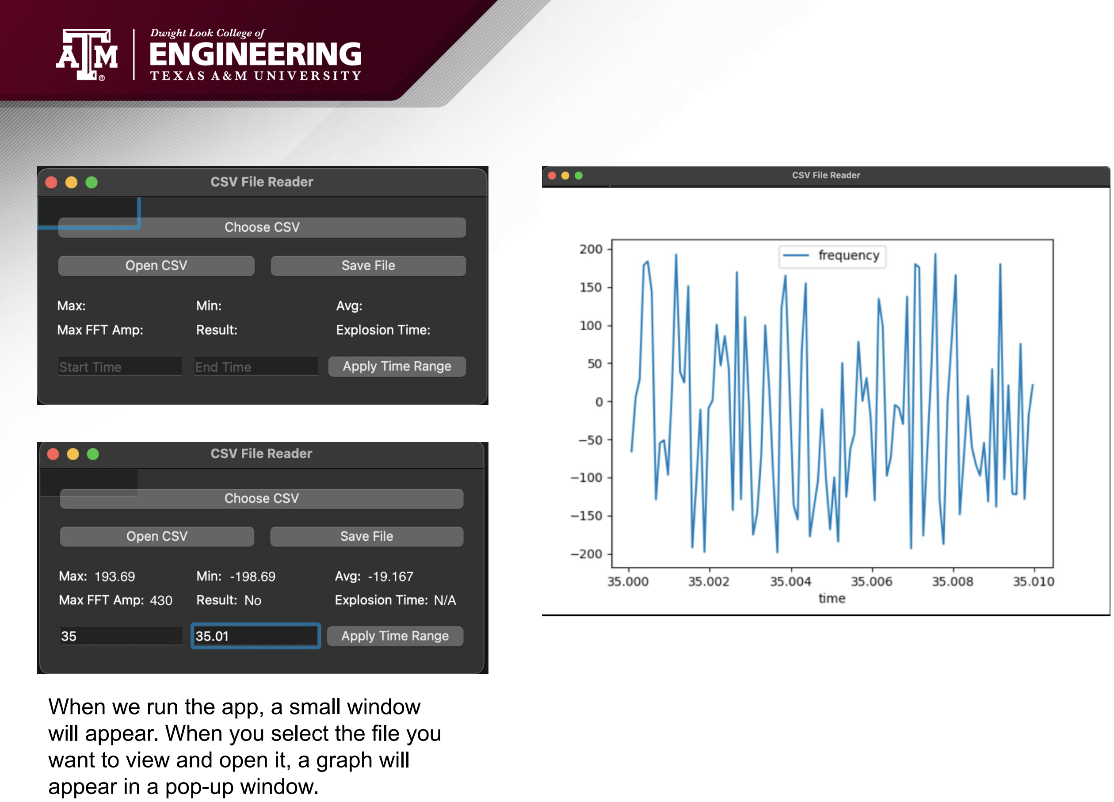
[picture p49: page 11]

## When we run the app, a small window will appear. When you select the file you want to view and open it, a graph will

appear in a pop-up window.

# Thank you!

# Questions?
