ecbarnes116/TAMU_ECEN_403-404_Shared/ECEN_404_Status_Update_9-25-2023.pdf

# Portable High Energy Experiment (PHEE) DAQ

# Team Members: Ethan Barnes John Sabra Sang Hoon Chung

# Sponsor: Michelle Chatter Sandia National Laboratories TA: Logan Smith


# Project Summary

# Problem statement:

# - The United States military possesses about 5500 nuclear weapons in its stockpile

# - The security of these weapons and equipment is paramount when they are transported for storage and testing

# - Sandia is interested in detecting explosive-type events in sensitive areas – Exact application for DAQ system may not be disclosed

# The Portable High Energy DAQ System will:

# - Protect government equipment by detecting and identifying explosives within a 100 ft range – Utilizes accelerometer and pressure sensor to classify if an explosive event occurred - Write output to removable storage device – User will be able to refer to and perform analysis on past data

# Project/Subsystem Overview


# Team: PHEE DAQ (Sandia)

| 9/10 | 9/24 | 10/8 | 10/22 | 11/5
Johnny | PCB Ordered | Power supply PCB validated | Charging feature validated | Integrated PCB design complete | Integrated PCB is functional
| Zero design violations in Altium | Regulates 3.3 V under 40mA load and 5 V under 120 mA load (estimated load current of MCU) | Can charge a 3-cell lipo battery at 1C rate
Ethan | PCB design complete | MCU runs independently | PCB is functional | Zero design violations in Altium

Can be powered with 3.3V
source and can read from
sensors and write to SD
card at more than 2 kHz

Integrated PCB is
portable with power
supply regulating battery
voltage to 3.3 and 5V
under load
Zero design violations in Altium | Program will start and stop from GPIO outside of debug mode | Powered with 3.3 V source, can write to SD card at ~2 kHz Pressure sensors test pending
Sang Hoon | Change Framework to PyQt and Design multiple signals on GUI | Add more metrics to display for data | Make GUI more user-friendly | Finalizing the program and adopting the software | Validate and test communication between subsystems
| Check the application shows whole sensors data | Add more metrics and check availability of the result Display via the application at next column | Ask opinions to other people about the design of GUI | Check the software works when we download the software itself as .exe file | Application can read data from SD card in desired format (time, explosion, pressure, acceleration)

# Execution


# Accomplishments since the last presentation <15> hrs

# Ongoing progress/problems and plans until the next presentation

# - PCB arrived and in hand

# - All PCB components have been soldered onto the board

# - Integrated PCB Micro SD reader circuit footprints completed

# - Short discovered between the two ground pins of the battery connector causing header to melt therefore testing cannot be

done with battery.

# - DC power supply in lab cannot supply high enough input voltage to test accurately - Must reroute traces to correct issue and order revised PCB

Portable Power Supply | Johnny Sabra

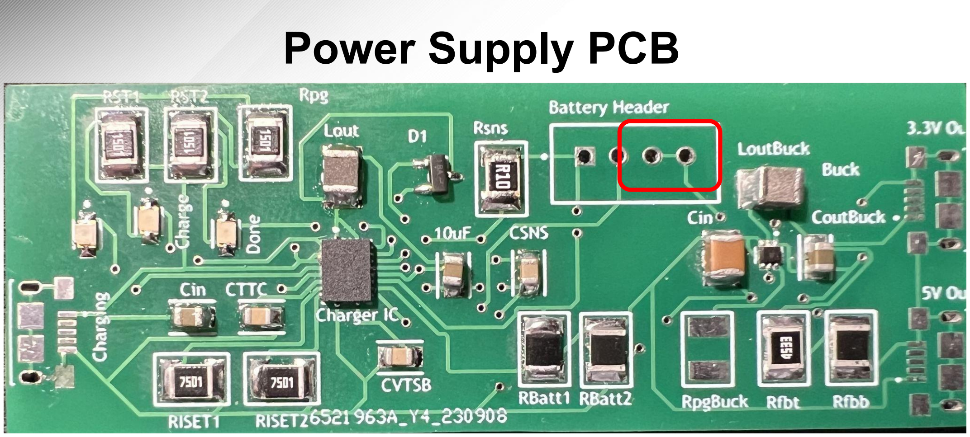
[picture p50: figure]
Power Supply PCB

# - Battery header shorted between ground pins

# - Was tested with 6V input voltage (should be 11.7V)

Accomplishments since the last presentation <20> hrs | Ongoing progress/problems and plans until the next presentation
- Completed PCB schematics | ● Finishing PCB layout and order this week ● Continue integration with power supply PCB
Microcontroller PCB | Ethan Barnes

## - Ran into problems with sensor signal input sensors and micro USB power supply - Resolved issues with help from peers and professors

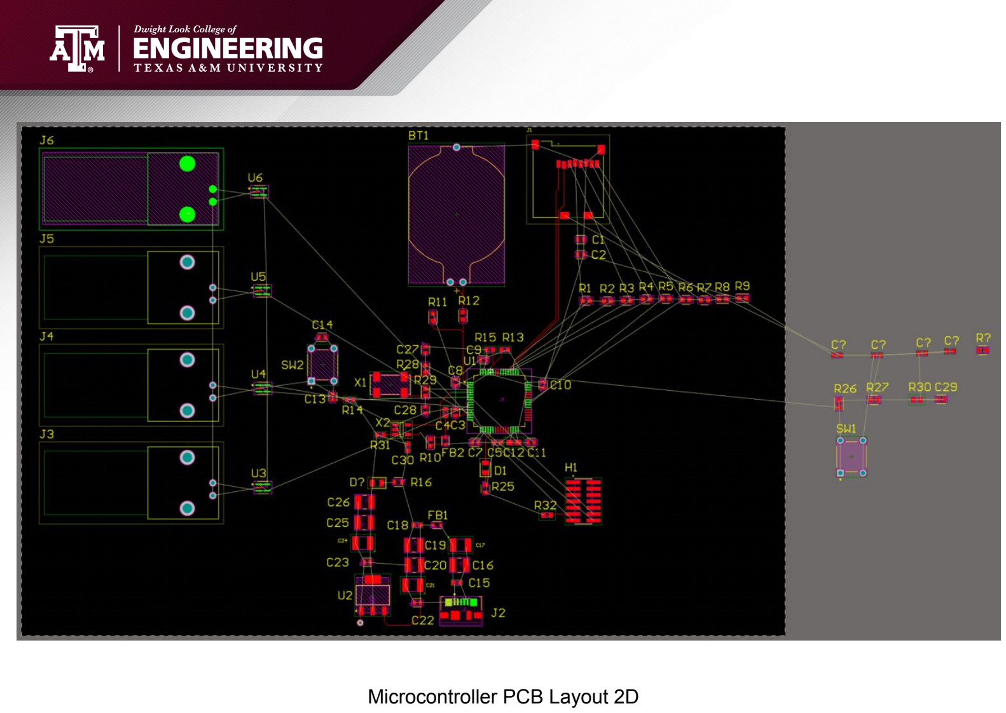
[picture p51: page 9]

## Microcontroller PCB Layout 2D

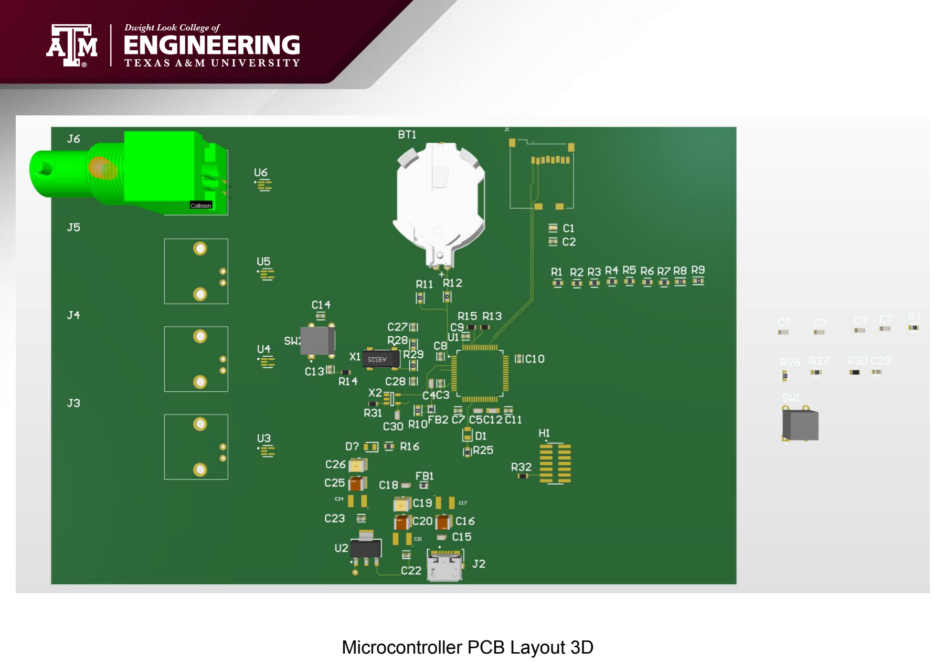
[picture p52: page 10]

## Microcontroller PCB Layout 3D

Application | Sang Hoon Chung
Accomplishments since the last presentation <20> hrs | Ongoing progress/problems and plans until the next presentation
- Link to Google Drive with using Google API ● Read multiple signals from sensors | ● Add 2nd and 3rd sensors’ signal analysis(Depends on the MCU result). ● Edit the design of the GUI more user friendly.

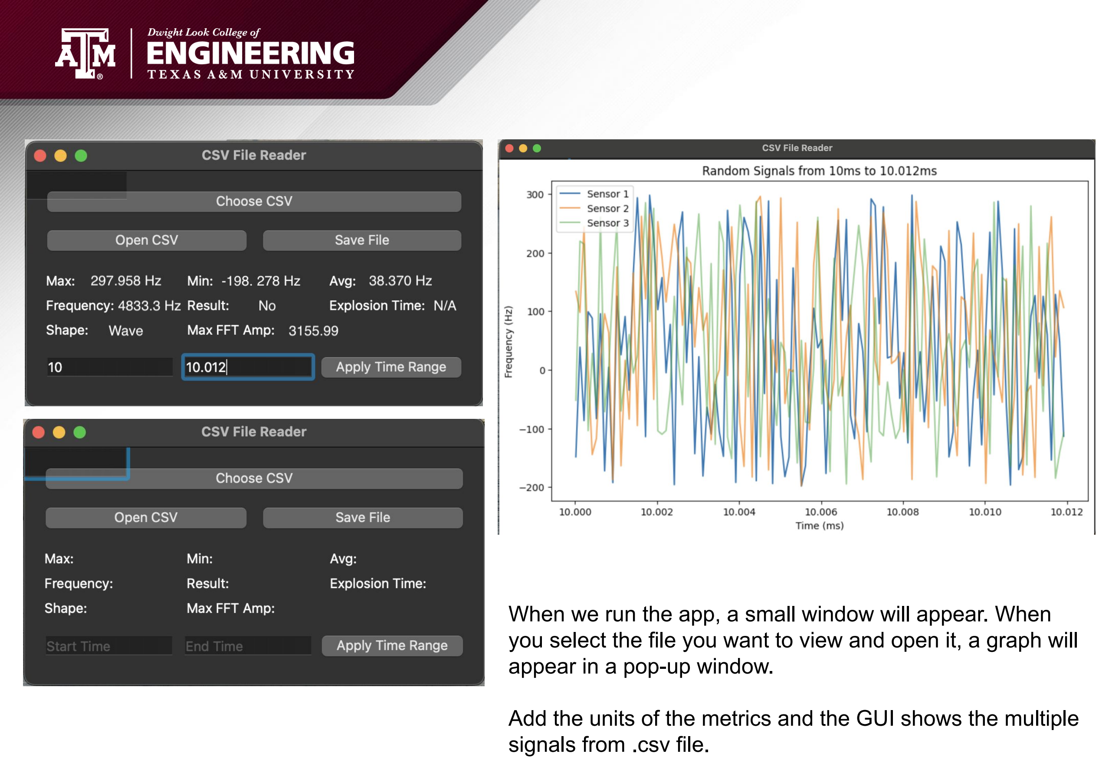
[picture p53: page 12]

## When we run the app, a small window will appear. When you select the file you want to view and open it, a graph will

appear in a pop-up window.

## Add the units of the metrics and the GUI shows the multiple

signals from .csv file.

# Thank you!

# Questions?
