ecbarnes116/TAMU_ECEN_403-404_Shared/Status Update 5 (2).pdf

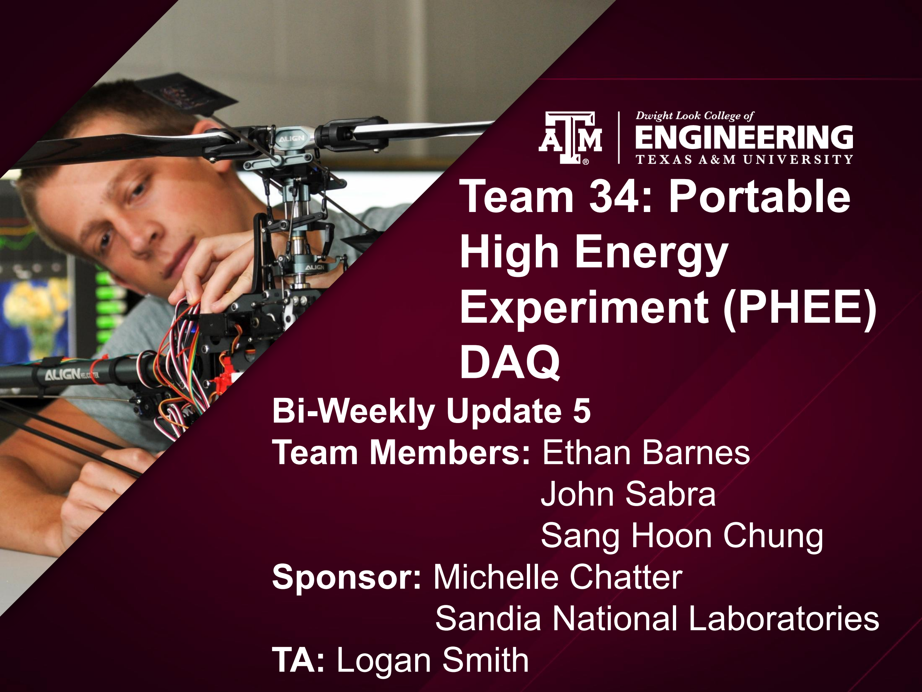
[picture p54: page 1]

# Team 34: Portable High Energy Experiment (PHEE) DAQ

# Bi-Weekly Update 5 Team Members: Ethan Barnes John Sabra Sang Hoon Chung Sponsor: Michelle Chatter Sandia National Laboratories TA: Logan Smith


# Project Summary

# Problem statement:

# - The United States military possesses about 5500 nuclear weapons in its stockpile

# - The security of these weapons and equipment is paramount when they are transported for storage and testing

# - Sandia is interested in detecting explosive-type events in sensitive areas – Exact application for DAQ system may not be disclosed

# The Portable High Energy DAQ System will:

# - Protect government equipment by detecting and identifying explosives within a 100 ft range – Utilizes accelerometer and pressure sensor to classify if an explosive event occurred - Write output to removable storage device – User will be able to refer to and perform analysis on past data

# System Overview


# Team: PHEE DAQ (Sandia)

| 9/10 | 9/24 | 10/8 | 10/22 | 11/5
Johnny | PCB Ordered | Power supply PCB validated | Charging feature validated | Integrated PCB design complete | Integrated PCB is functional
| Zero design violations in Altium | Regulates 3.3 V under 40mA load and 5 V under 120 mA load (estimated load current of MCU) | Can charge a 3-cell lipo battery at 1C rate
Ethan | PCB design complete | MCU runs independently | PCB is functional | Zero design violations in Altium

Can be powered with 3.3V
source and can read from
sensors and write to SD
card at more than 2 kHz

Integrated PCB is
portable with power
supply regulating battery
voltage to 3.3 and 5V
under load
Zero design violations in Altium | Program will start and stop from GPIO outside of debug mode | Powered with 3.3 V source, can write to SD card at ~2 kHz Pressure sensors test pending
Sang Hoon | Change Framework to PyQt and Design multiple signals on GUI | Add more metrics to display for data | Make GUI more user-friendly | Finalizing the program and adopting the software | Validate and test communication between subsystems
| Check the application shows whole sensors data | Add more metrics and check availability of the result Display via the application at next column | Ask opinions to other people about the design of GUI | Check the software works when we download the software itself as .exe file | Application can read data from SD card in desired format (time, explosion, pressure, acceleration)

# Execution


# Accomplishments since the last presentation <20> hrs

# Ongoing progress/problems and plans until the next presentation

# - Power supply tested with range of input voltages when expected is 5V

# - SD card footprint corrected

# - Integrated PCB ordered and arriving Friday 10/27

# - MCU cannot detect SD card

# - Data cannot be written to SD card - footprint error where pad is shorted to SD socket casing

# - Integrated PCB must be soldered and validated

PHEE DAQ System | Johnny Sabra & Ethan Barnes
Input Voltage (V) | 3.7 V | 4.5 V
Output Voltage (V) | 3.289 | 3.311

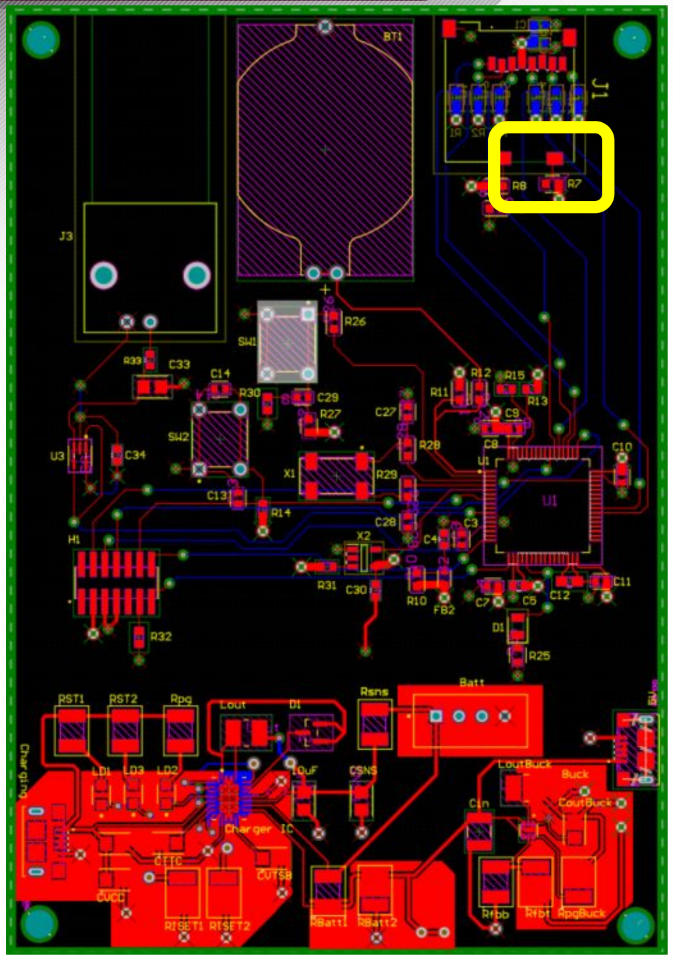
[picture p55: figure]

# - Integrated PCB

# – SD card reader footprint corrected by moving SDIO_CD pad 40 mil to the right to provide more clearance for the case

# - Polygons added for better heat dissipation

# - Power ground outputs corrected at the output of battery charger

# - Arriving this Friday 10/27

## SD card mounts correctly, but files cannot be created due to FatFs FR_DISK_ERR

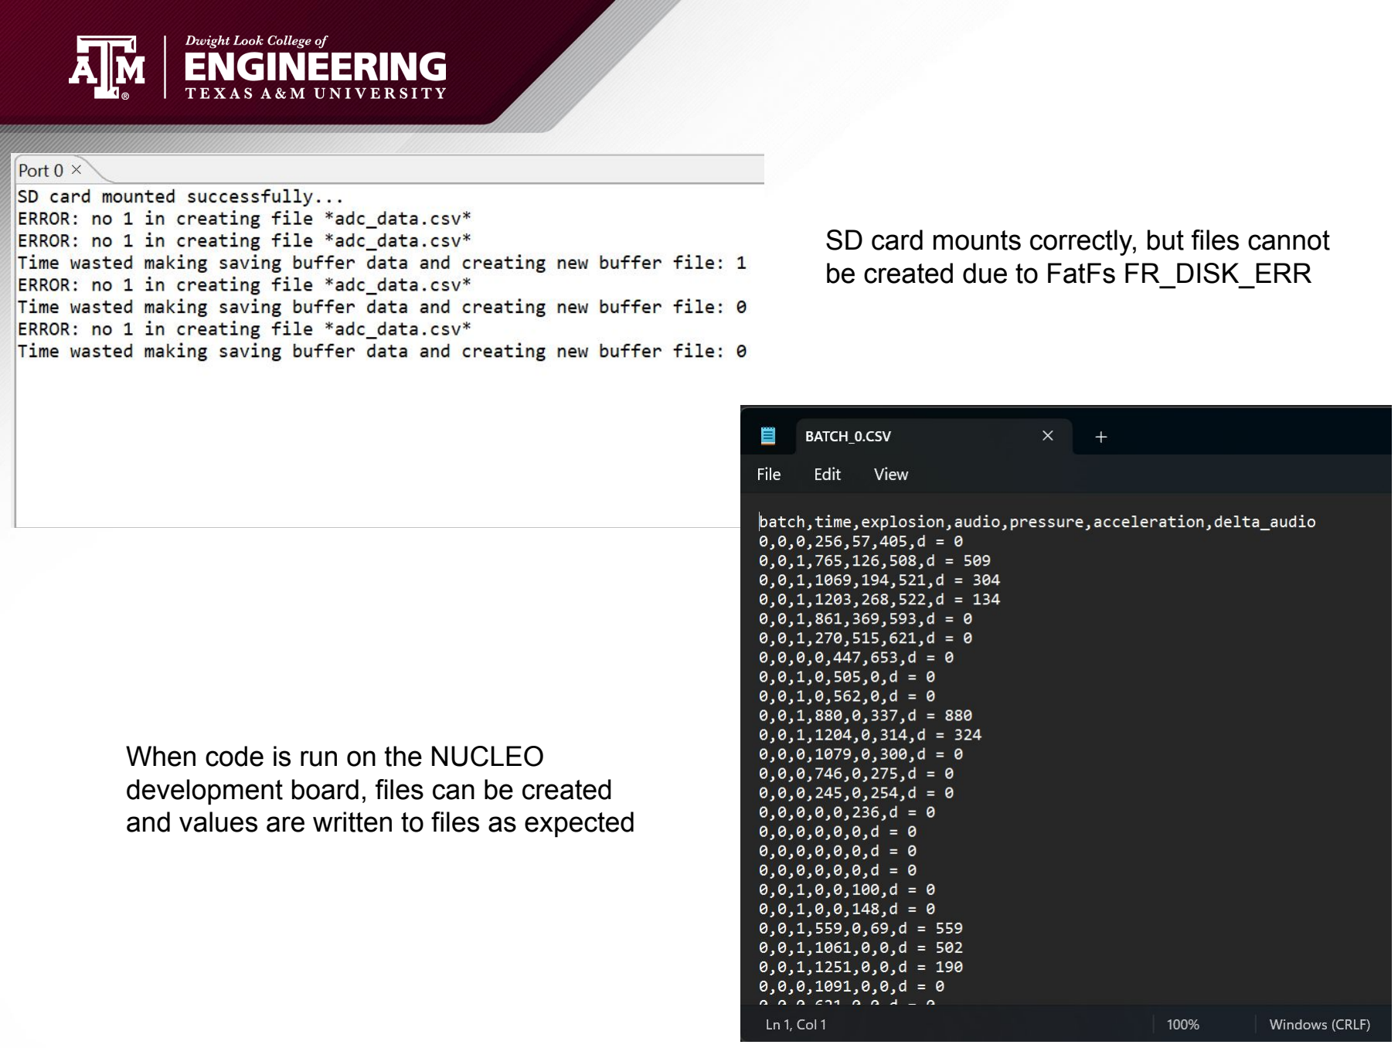
[picture p56: page 8]

## When code is run on the NUCLEO development board, files can be created and values are written to files as expected

Application | Sang Hoon Chung
Accomplishments since the last presentation <9> hrs | Ongoing progress/problems and plans until the next presentation
- Simulate the app with the Friedlander waveform which is similar to the blast wave ● Check the software recognize the SD card or external Drive | ● Validate and test communication between subsystems. ● Keep communicate with sponsor and fix any changes.

## How the app for GUI works

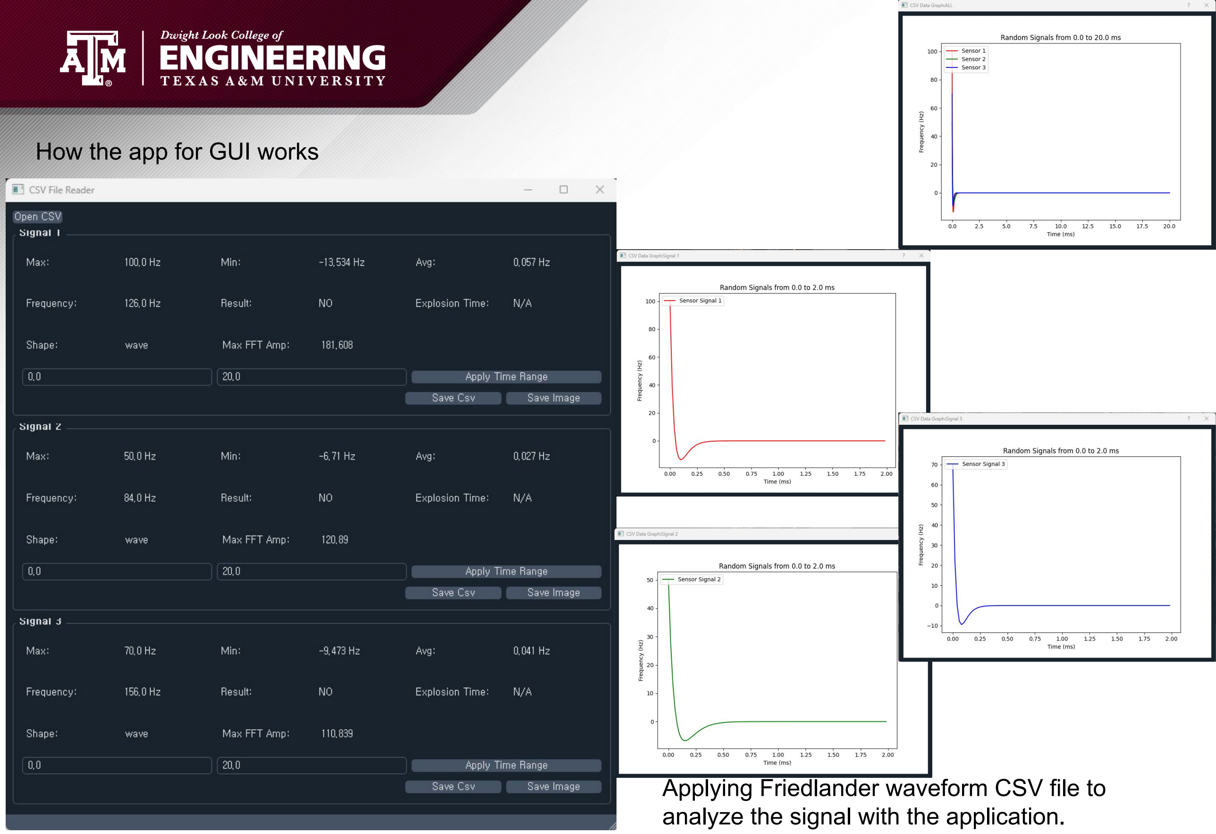
[picture p57: page 10]

## Applying Friedlander waveform CSV file to

analyze the signal with the application.

# Thank you!

# Questions?
