ecbarnes116/TAMU_ECEN_403-404_Shared/(list of files, drawings)

Other design files:
Ethan/PCB/ECEN_404.PrjPcb
Ethan/PCB/MCU.SchDoc
Ethan/PCB/MCU_PCB_1.PcbDoc
Ethan/PCB/microSD_reader.SchDoc
Ethan/PCB/power.SchDoc
Ethan/PCB/sensors.SchDoc
PowerSupplySubsystem/BatteryCharger.SchDoc
PowerSupplySubsystem/BuckConverter.SchDoc
PowerSupplySubsystem/PowerSupply.PcbDoc
PowerSupplySubsystem/PowerSupply.PcbLib
PowerSupplySubsystem/PowerSupply.SchLib
