ecbarnes116/TAMU_ECEN_403-404_Shared/Ethan/STM32/SDIO_F446RE/Core/Src/main.c

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
/* Includes ------------------------------------------------------------------*/
#include "main.h"
#include "fatfs.h"

/* USER CODE BEGIN Includes */

#include "stdio.h"
#include <string.h>
#include <math.h>
#include <time.h>
//#include "file_handling.h"
//#include "UartRingbuffer.h"

/* USER CODE END Includes */

/* USER CODE BEGIN PD */
// Total number of samples across each channel (4*1000 = buffer size of 4000 < 4096 maximum)
// Currently (4*100 = buffer size of 400)
#define ADC_BUFFER_SIZE 400

#define BUFFER_SIZE 128
//#define PATH_SIZE 32

// Char buffer to be written to SD card
// Every sample is appended to this buffer
#define SD_BUFFER_SIZE 2500

// Threshold values to detect explosion
// ADC readings are compared to these values after they are converted to the desired units
#define THRESHOLD_AUDIO 	   40
#define THRESHOLD_PRESSURE 	   4.6 // Change in pressure (kPa)
#define THRESHOLD_ACCELERATION 40

// Multiple of number of samples read from ADC
// Num of samples written to file before saving = CLUSTER_SIZE * ADC_BUFFER_SIZE/(num_sensors*2)
// 10,000 = 200 * (400/8)
#define CLUSTER_SIZE 200

// Internal reference voltage for STM32F446RE (mV)
// Multiply by this value to convert raw voltage input to voltage in mV
#define REFERENCE_VOLTAGE_CONVERSION 1000.0/1200.0
// Reference sensitivity for microphone (mV)
// TODO: Need to check with Sandia to make sure this is correct
#define AUDIO_REFERENCE 1.00
// Reference sensitivity for pressure sensor (mV) (14.62 mV/kPa)
#define PRESSURE_REFERENCE 14.62
// Pref is the reference pressure in air, which is 20x10-6 Pa
#define P_REF 0.00002
// Reference sensitivity for accelerometer x-axis (mV)
#define ACC_REFERENCE_X 50.00
// Reference sensitivity for accelerometer y-axis (mV)
#define ACC_REFERENCE_Y 48.97

/* USER CODE END PD */

ADC_HandleTypeDef hadc1;
DMA_HandleTypeDef hdma_adc1;

RTC_HandleTypeDef hrtc;

SD_HandleTypeDef hsd;

UART_HandleTypeDef huart2;

/* USER CODE BEGIN PV */

// 16 bit (Half Word) ADC DMA data width
// ADC array for data (size of 400, width of 16 bits)
// I am only getting 12 bits from the ADC, so 4 bits of memory are wasted per ADC reading)
uint16_t adc_data[ADC_BUFFER_SIZE];

// FIXME: These are not currently being used
uint16_t audio_arr[ADC_BUFFER_SIZE/8];
uint16_t pressure_arr[ADC_BUFFER_SIZE/8];
uint16_t acc_arr[ADC_BUFFER_SIZE/8];

// TODO: Create array to hold date/time info when implemented
// data_type??? time_arr[ADC_BUFFER_SIZE/8];

// Pointer to index of adc_data array
// Used for ping pong buffer to set the start index at the halfway point of the adc_data array
static volatile uint16_t *fromADC_Ptr;
//static volatile uint16_t *toSD_Ptr = &adc_data[0];

char buffer[BUFFER_SIZE];	// Store strings for f_write
//char path[PATH_SIZE];		// buffer to store path

// Buffer that is written to SD card
char SD_buffer[SD_BUFFER_SIZE];

// Flag set when DMA buffer is either half-full or completely full
volatile uint8_t dataReady;
// Flag set when DMA buffer is half-full
volatile uint8_t dmaHalf;
// Flag set when DMA buffer is completely full
volatile uint8_t dmaFull;

/* USER CODE END PV */

void SystemClock_Config(void);
static void MX_GPIO_Init(void);
static void MX_DMA_Init(void);
static void MX_USART2_UART_Init(void);
static void MX_ADC1_Init(void);
static void MX_SDIO_SD_Init(void);
static void MX_RTC_Init(void);
/* USER CODE BEGIN 0 */

// These are already defined in file_handling.c
FATFS fs; // file system object
FIL fil; // file object
FILINFO fno;		// ???
FRESULT fresult;
UINT br, bw;
FATFS *pfs;
DWORD fre_clust;
uint32_t total, free_space;

// Controls amount of data written to buffer fileeee
uint8_t cluster = 0;
// Keeps track of number of files saved out with useful data
uint16_t batch = 0;

// 1 if an explosion was detected between two samples
uint8_t explosionDetected = 0;
// 1 if there was an explosion detected for an entire batch
uint8_t SAVE_BUFFER_FILE = 0;

// Value to store state of SW1 push button
uint8_t button_value = 0;

int saveBufferStart;
int saveBufferStop;

float current_audio;
float current_pressure;
float current_acc;

float current_acc_x;
float current_acc_y;

float previous_audio;
float previous_pressure;
float previous_acc;

float previous_acc_x;
float previous_acc_y;

float delta_audio;
float delta_pressure;
float delta_acc;

int _write(int file, char *ptr, int length) {
	int i = 0;

	for(i = 0; i < length; i++) {
		ITM_SendChar((*ptr++));
	}

	return length;
}

int bufsize (char *buf) {
	int i=0;
	while (*buf++ != '\0') i++;
	return i;
}


// Clear UART buffer for debugging
void bufclear(void) {
	for(int i = 0; i < BUFFER_SIZE; i++){
		buffer[i] = '\0';
	}
}

void SDbufclear(void) {
	for(int i = 0; i < SD_BUFFER_SIZE; i++){
		SD_buffer[i] = '\0';
	}
}

// Size of buffer needs to be a multiple of number of ADC channels (minimum of 4)
// Needs to be divisible by the number of bytes in each line
// that I am writing to the SD card				<-- What did I mean by this???

// Called when ADC buffer is half filled
void HAL_ADC_ConvHalfCpltCallback(ADC_HandleTypeDef* hadc) {
	dmaFull = 0;

	fromADC_Ptr = &adc_data[0];
	dataReady = 1;
}

// Called when ADC buffer is completely filled
void HAL_ADC_ConvCpltCallback(ADC_HandleTypeDef* hadc) {

	fromADC_Ptr = &adc_data[ADC_BUFFER_SIZE/2];

	dmaFull = 1;
	dataReady = 1;
}





void writeSD(const void* buffer, uint16_t len) {
	// Moves the file read/write pointer to the end of the file
	fresult = f_lseek(&fil, f_size(&fil));

	// Write the buffer (data worth half of DMA buffer) to the file
	fresult = f_write(&fil, buffer, len, &bw);

	// f_sync flushes the cached information of a writing file
	//
	// Performs the same process as f_close function but the file is left opened
	// and can continue read/write/seek operations to the file
//	fresult = f_sync(&fil);
}






void processData() {
	uint8_t channel = 0;
	uint16_t write_len = 0;

	// Keeps track of the "global sample" (i.e, every 4 ADC readings)
	uint8_t sample_index = 0;

	snprintf(SD_buffer, SD_BUFFER_SIZE, "%s", "\0"); // Empty char (null char)

	for(uint8_t i = 0; i < (ADC_BUFFER_SIZE)/2; i++) {

		// These if statements will allow me to save the readings of the ADC to the
		// correct sensor variable because each reading is for a different sensor
		//
		// Store the new value read into its respective array
		// audio_arr 	= [0, 30, 56, 70, 56, 30, 0]
		// pressure_arr = [0, 30, 56, 70, 56, 30, 0]
		//
		// index 0 of audio_arr corresponds with the same reading for pressure_arr
		if	   ((i % 4) == 0) {
			// Convert raw sensor value to dB
			// ##.## mV/Pa
			// V*1200 = value (V)
			// V = value/1200 (V)
			// V = (value/1200)*1000 (mV)
			// V = value * voltage_conversion (mV)
			// A = V/##.## (mV*(Pa/mV))
			// A = (value*voltage_convsersion)/##.## (Pa)
			//
			// Sound Pressure Level:
			// SPL = 20log10(P/Pref)
			// P:    pressure (Pa)
			// Pref: reference pressure in air 20x10-6 (Pa)
			//
			// SPL = 20log10(A/Pref) (dB)
			current_audio = fromADC_Ptr[i];
			current_audio = (current_audio * REFERENCE_VOLTAGE_CONVERSION) / AUDIO_REFERENCE;
			current_audio = 20 * log10(current_audio/P_REF);

//			audio_arr[sample_index] = current_audio;

			// Get time here (first reading will count as the time the sample was read)
			// Write this value to the temp string when current_audio is written

			// current_time = some_function_to_get_time_in_micro_seconds()
			// time_arr[sample_index] = current_time
		}
		else if((i % 4) == 1) {
			// Convert raw sensor value to kPa
			// 14.62 mV/kPa
			// V*1200 = value (V)
			// V = value/1200 (V)
			// V = (value/1200)*1000 (mV)
			// V = value * voltage_conversion (mV)
			// P = V/14.62 (mV*(kPa/mV))
			// P = (value*voltage_convsersion)/14.62 (kPa)
			current_pressure = fromADC_Ptr[i];
			current_pressure = (current_pressure * REFERENCE_VOLTAGE_CONVERSION) / PRESSURE_REFERENCE;

//			pressure_arr[sample_index] = current_pressure;

		}
		else if((i % 4) == 2) {
			// Convert raw sensor value to g
			// 50.00 mV/g
			// V*1200 = value (V)
			// V = value/1200 (V)
			// V = (value/1200)*1000 (mV)
			// V = value * voltage_conversion (mV)
			// a = V/50.00 (mV*(g/mV))
			// a = (value*voltage_convsersion)/50.00 (g)
			current_acc_x = fromADC_Ptr[i];
			current_acc_x = (current_acc_x * REFERENCE_VOLTAGE_CONVERSION) / ACC_REFERENCE_X;
		}
		else if((i % 4) == 3) {
			// Convert raw sensor value to g
			// 48.97 mV/g
			// V*1200 = value (V)
			// V = value/1200 (V)
			// V = (value/1200)*1000 (mV)
			// V = value * voltage_conversion (mV)
			// a = V/48.97 (mV*(g/mV))
			// a = (value*voltage_convsersion)/48.97 (g)
			current_acc_y = fromADC_Ptr[i];
			current_acc_y = (current_acc_y * REFERENCE_VOLTAGE_CONVERSION) / ACC_REFERENCE_Y;

			// Get magnitude of acceleration in x and y axes
			current_acc = sqrt((current_acc_x*current_acc_x) + (current_acc_y*current_acc_y));
//			current_acc = current_acc_x;
//			acc_arr[sample_index] = current_acc;
		}

		// Treat every 4th reading like one reading
		if((i % 4) == 3) {
			// Only want to get deltas every 4 readings on the 4th reading because all values
			// only update after 4 total readings from the ADC (4 values, one per reading)
			if(current_audio > previous_audio) {
				delta_audio = current_audio - previous_audio;
			}
			else {
				delta_audio = 0;
			}
			if(current_pressure > previous_pressure) {
				delta_pressure = current_pressure - previous_pressure;
			}
			else {
				delta_pressure = 0;
			}
			if(current_acc > previous_acc) {
				delta_acc = current_acc - previous_acc;
			}
			else {
				delta_acc = 0;
			}

			// Do explosion detection here
			if(delta_pressure >= THRESHOLD_PRESSURE) {
				// Explosion detected bit set for the first time
				// This bit needs to stay set to 1
				explosionDetected = 1;
				SAVE_BUFFER_FILE = 1;
			}

			// Edge case for very first ADC sample (first 4 readings) where previous information does not exist
			// Don't need (dmaFull == 0)
			// if((i <= 3) && (dmaFull == 0) && (cluster == 0) && (batch == 0)) {
			if((i <= 3) && (cluster == 0) && (batch == 0)) {
				delta_audio = 0;
				delta_pressure = 0;
				delta_acc = 0;

				explosionDetected = 0;
				SAVE_BUFFER_FILE = 0;
			}

			// FIXME: Figure out how to explain this
		    // Append new string using length of previously added string
//			snprintf(SD_buffer + strlen(SD_buffer),
//					SD_BUFFER_SIZE - strlen(SD_buffer),
//					"%d,%d,%d,%.3f,%.3f\r\n",
//					batch, cluster, explosionDetected, current_pressure, delta_pressure);

			uint8_t zero = 0;
			snprintf(SD_buffer + strlen(SD_buffer),
					SD_BUFFER_SIZE - strlen(SD_buffer),
					"%d,%d,%d,%.3f,%.3f\r\n",
					zero, cluster, explosionDetected, current_pressure, delta_pressure);

			// The current samples will be the "previous" samples for the next samples
			// These are placed in this loop for the same reason that the deltas are placed here
			previous_audio = current_audio;
			previous_pressure = current_pressure;
			previous_acc = current_acc;

			previous_acc_x = current_acc_x;
			previous_acc_y = current_acc_y;

			sample_index++;
		}

		// Use Friedlander waveform to estimate how long the explosion will last for,
		// then set flag to 0 when time reaches that value
		explosionDetected = 0;

		// Increment channel counter to read from next channel
		if(channel < 3) {
			channel += 1;
		}
		else {
			channel = 0;
		}
	}
	// Get length of huge buffer to be written to SD card
	write_len = strlen(SD_buffer);
	// Finally, write huge buffer to SD card
	writeSD(SD_buffer, write_len);

	// Clear SD_buffer so new data can be written (next half of DMA buffer)
	SDbufclear();

	dataReady = 0;
}





void saveBufferFile() {
	char file_name[20];

	// Do something here
	fresult = f_close(&fil);

	// FIXME: This is
	// need to have variable length string for file name (depends on batch #)
	snprintf(file_name, BUFFER_SIZE, "BATCH_%d.csv", batch);
	snprintf(file_name, strlen(file_name)+1, "BATCH_%d.csv", batch);

	f_rename("adc_data.csv", file_name);
}





// TODO: Write function to overwrite existing buffer file
// Doing this avoids wasting time by:
//	1. Creating and opening a new file
//	2. Writing the column names to that file
void overwriteBufferFile() {
	// Do this if the buffer file does not need to be saved
	// Begin writing over current buffer file (skipping the column names)



	// Moves the file read/write pointer to the beginning of the 2nd line
//	fresult = f_lseek(&fil, f_size(&fil));
//	fresult = f_lseek(&fil, strlen(column_names));

}





void setupBufferFile() {
	char *name = "adc_data.csv";

	fresult = f_stat(name, &fno);

	if (fresult == FR_OK) {
		printf("*%s* already exists!!!\n",name);
		bufclear();
	}
	else {
		// FA_CREATE_ALWAYS
		// Creates a new file. If the file is existing, it will be truncated and overwritten.
		fresult = f_open(&fil, name, FA_CREATE_ALWAYS|FA_READ|FA_WRITE);
	}

	if(fresult != FR_OK) {
		printf ("ERROR: no %d in creating file *%s*\n", fresult, name);
		bufclear();
	}
	else {
		printf ("*%s* created successfully\n",name);
		bufclear();
	}

	fresult = f_printf(&fil, "batch,cluster,explosion,pressure,delta_pressure\r\n");
}





/* USER CODE END 0 */

/**
  * @brief  The application entry point.
  * @retval int
  */
int main(void)
{
  /* USER CODE BEGIN 1 */

	// Make sure conversion value is correct
//	printf("REFERENCE_VOLTAGE_CONVERSION: %.3f\r\n", REFERENCE_VOLTAGE_CONVERSION);

  /* USER CODE END 1 */

  /* MCU Configuration--------------------------------------------------------*/

  /* Reset of all peripherals, Initializes the Flash interface and the Systick. */
  HAL_Init();

  /* Configure the system clock */
  SystemClock_Config();

  /* Initialize all configured peripherals */
  MX_GPIO_Init();
  MX_DMA_Init();
  MX_USART2_UART_Init();
  MX_ADC1_Init();
  MX_SDIO_SD_Init();
  MX_FATFS_Init();
  MX_RTC_Init();
  /* USER CODE BEGIN 2 */

  // Start DMA buffer
  HAL_ADC_Start_DMA(&hadc1, (uint16_t*)adc_data, ADC_BUFFER_SIZE);

  // Mount SD card
  fresult = f_mount(&fs, "", 0);

  if(fresult != FR_OK){
	  printf("ERROR in mounting SD card...\n");
  }
  else {
	  printf("SD card mounted successfully...\n");
  }

//  // Check free space on SD card
//  f_getfree("", &fre_clust, &pfs);
//
//  total = (uint32_t)((pfs->n_fatent - 2) * pfs->csize * 0.5);
//  printf("SD card total size: \t%lu\n", total);
//  bufclear();
//  free_space = (uint32_t)(fre_clust * pfs->csize * 0.5);
//  printf("SD card free space: \t%lu\n", free_space);
//  bufclear();

  // Turn this setup process into a function

  char *name = "adc_data.csv";
  char *column_names = "batch,cluster,explosion,pressure,delta_pressure\r\n";

  fresult = f_stat(name, &fno);

  if (fresult == FR_OK) {
	  printf("*%s* already exists!!!\n",name);
	  bufclear();
  }
  else {
	  fresult = f_open(&fil, name, FA_CREATE_ALWAYS|FA_READ|FA_WRITE);
  }
	  if(fresult != FR_OK) {
		  printf ("ERROR: no %d in creating file *%s*\n", fresult, name);
		  bufclear();
	  }
	  else {
		  printf ("*%s* created successfully\n",name);
		  bufclear();
	  }

  fresult = f_printf(&fil, "batch,cluster,explosion,pressure,delta_pressure\r\n");

  // Get starting tick value (start timer)
  int start = HAL_GetTick();



  /* USER CODE END 2 */

  /* Infinite loop */
  /* USER CODE BEGIN WHILE */
  while (1)
  {
    /* USER CODE END WHILE */

    /* USER CODE BEGIN 3 */

	  if(dataReady) {

		  // Read BUFFER_SIZE/2 data points from ADC and add to buffer
		  processData();
		  // Increment cluster count
		  cluster++;

	  	  }

	  // Stop when cluster is a certain value (leads to unmount SD card)
	  // FIXME: UNDO THIS TO SHOW THRESHOLD ACTIVATION WORKS
	  // saveBufferFile() saves the previous buffer file as a new file with the corresponding batch number
	  // setupBufferFile() creates a new file which will be used as the next buffer file
//	  if((cluster >= CLUSTER_SIZE) && SAVE_BUFFER_FILE) {
	  if(cluster >= CLUSTER_SIZE) {
		  saveBufferStart = HAL_GetTick();
		  saveBufferFile();
		  setupBufferFile();
		  saveBufferStop = HAL_GetTick();

		  // printf("Time wasted saving buffer data and creating new buffer file: %d\r\n", saveBufferStop-saveBufferStart);

		  cluster = 0;
		  SAVE_BUFFER_FILE = 0;

		  batch++;
	  }
//	  else {
//		  // Do this if the buffer file does not need to be saved
//		  // Begin writing over current buffer file (skipping the column names)
//		  // overwriteBufferFile();
//
//		  // Or, just start writing another buffer file without saving the current buffer file
//		  cluster = 0;
//		  SAVE_BUFFER_FILE = 0;
//
//		  batch++;
//	  }

	  // This will eventually turn into an external interrupt from the user
	  // pressing a button
	  button_value = HAL_GPIO_ReadPin(B1_GPIO_Port, B1_Pin);

	  // TODO: Uncomment this for button stop functionality
	  if(button_value == 0) {
		  break;
	  }

	  if(batch >= 5) {
		  break;
	  }

  }

  int stop = HAL_GetTick();

  printf("Total time to write %d samples to SD card: %d ms\n", (ADC_BUFFER_SIZE/8)*CLUSTER_SIZE*batch, (stop - start));
  printf("Samples per second: %.3f\n", 1000.0*(ADC_BUFFER_SIZE/8)*CLUSTER_SIZE*batch/(stop - start));

  // Stop ADC DMA and disable ADC
  HAL_ADC_Stop_DMA(&hadc1);

  // Close buffer file
  f_close(&fil);
  if (fresult != FR_OK) {
	  printf ("ERROR: no %d in closing file *%s*\n", fresult, name);
	  bufclear();
  }

  // After while loop when break
  // Unmount SD card
  fresult = f_mount(NULL, "/", 1);
  if (fresult == FR_OK) {
	  printf("SD card unmounted successfully...\n");
	  bufclear();
  }
  else {
	  printf("ERROR: unmounting SD card\n");
	  bufclear();
  }

  /* USER CODE END 3 */
}

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
