ecbarnes116/TAMU_ECEN_403-404_Shared/(notices)

Notices in the files:
Ethan/STM32/SDIO_F446RE/Core/Src/main.c:
Copyright (c) 2023 STMicroelectronics.
All rights reserved.
This software is licensed under terms that can be found in the LICENSE file
